EPFLRocketTeam/SupersonicTestRocket/data_logs/Hermes_subsonicFlight_Kaltbrunn[04.09.2021]-RAW/atlimax_zoom.png

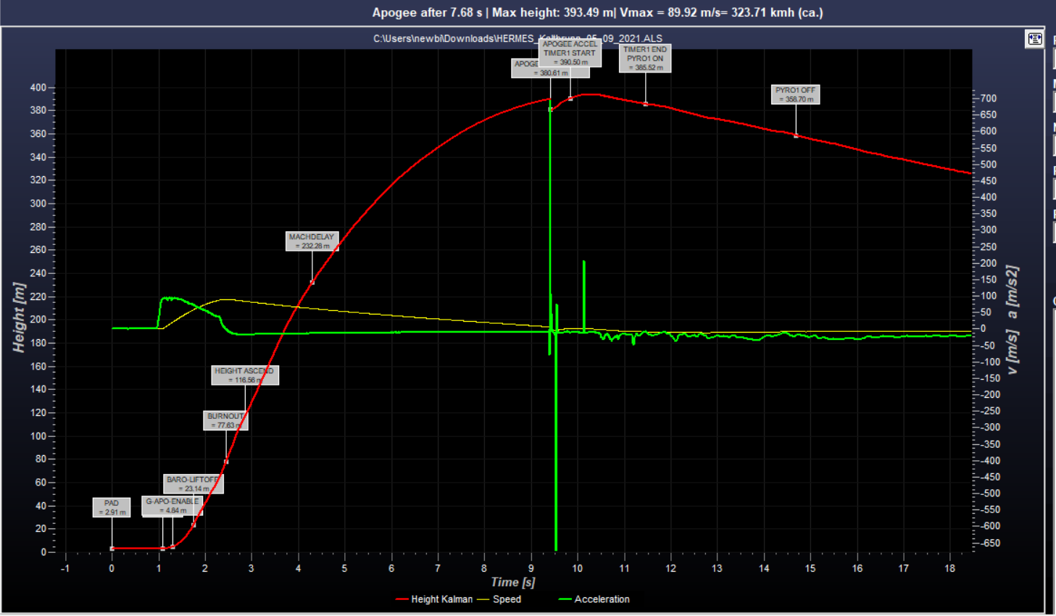
data_logs/Hermes_subsonicFlight_Kaltbrunn[04.09.2021]-RAW/atlimax_zoom.png
