EPFLRocketTeam/SupersonicTestRocket/datasheets/AISx120SX_registers.png

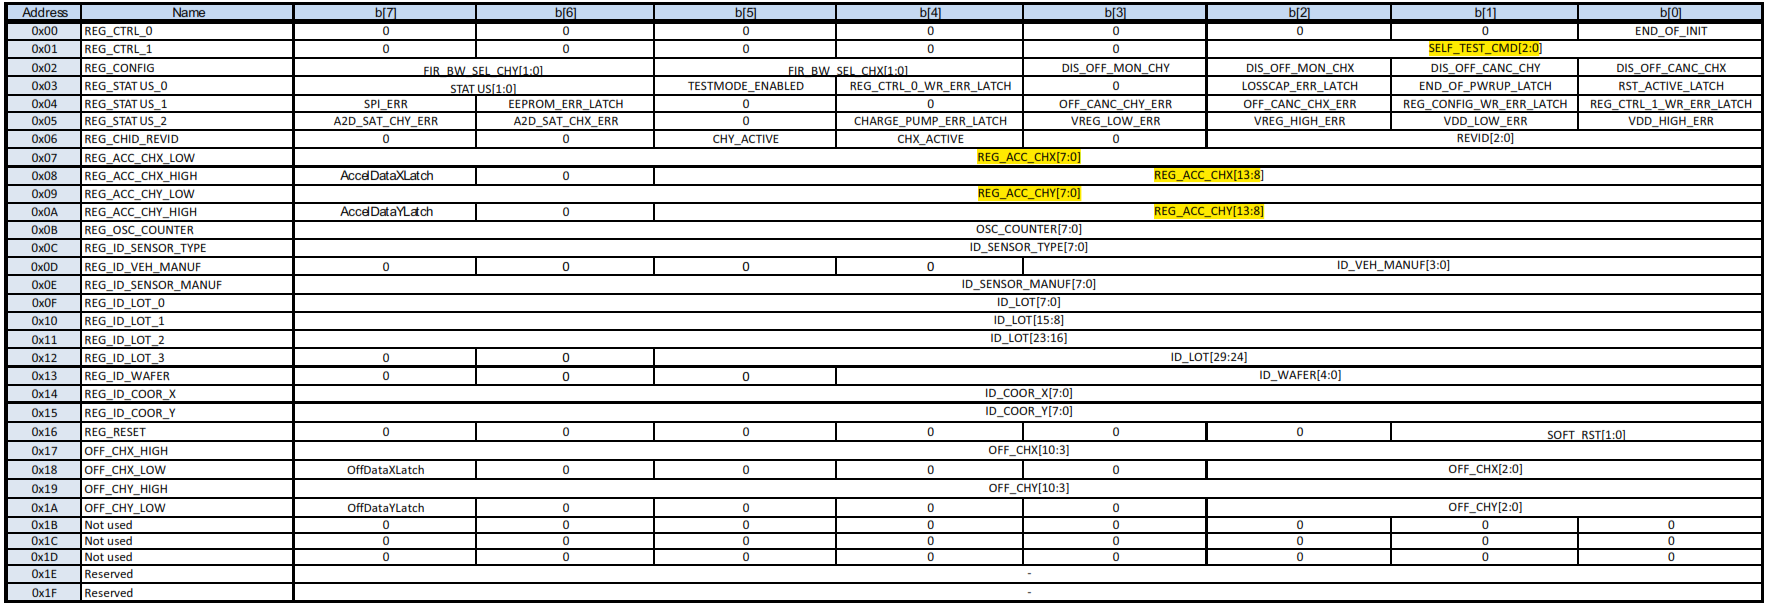
datasheets/AISx120SX_registers.png
