EPFLRocketTeam/SupersonicTestRocket/datasheets/nosecone_pinout.PNG

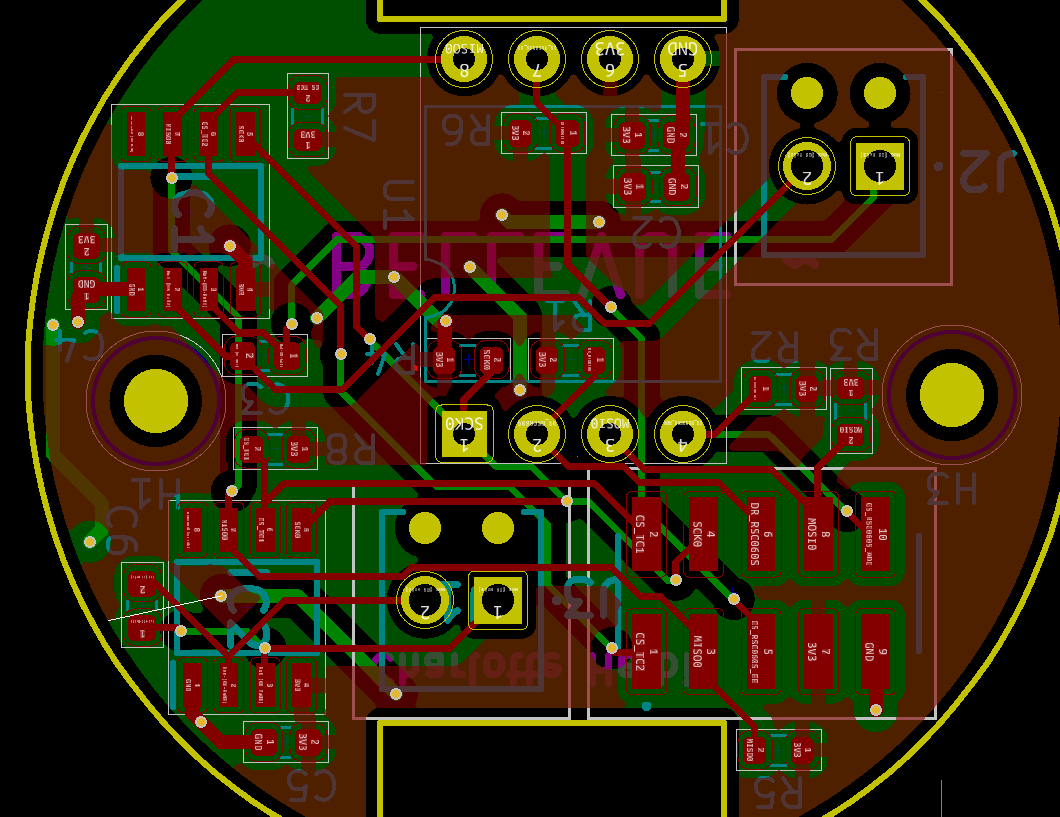
datasheets/nosecone_pinout.PNG
