EPFLRocketTeam/SupersonicTestRocket/doc_data_logger/html/class_honeywell_r_s_c___pressure___packet.png

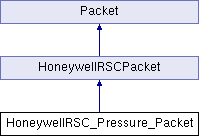
doc_data_logger/html/class_honeywell_r_s_c___pressure___packet.png
