EPFLRocketTeam/SupersonicTestRocket/PCB/PCB_v3_1/PCB_vf.png

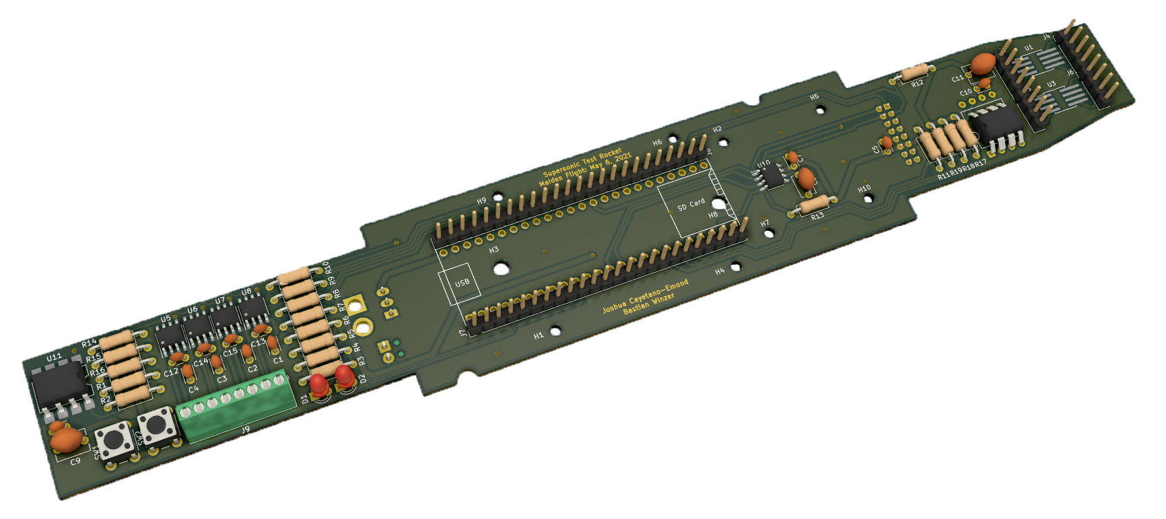
PCB/PCB_v3_1/PCB_vf.png
