EPFLRocketTeam/SupersonicTestRocket/PCB/PCB_v3_1/PCB_vf_3.png

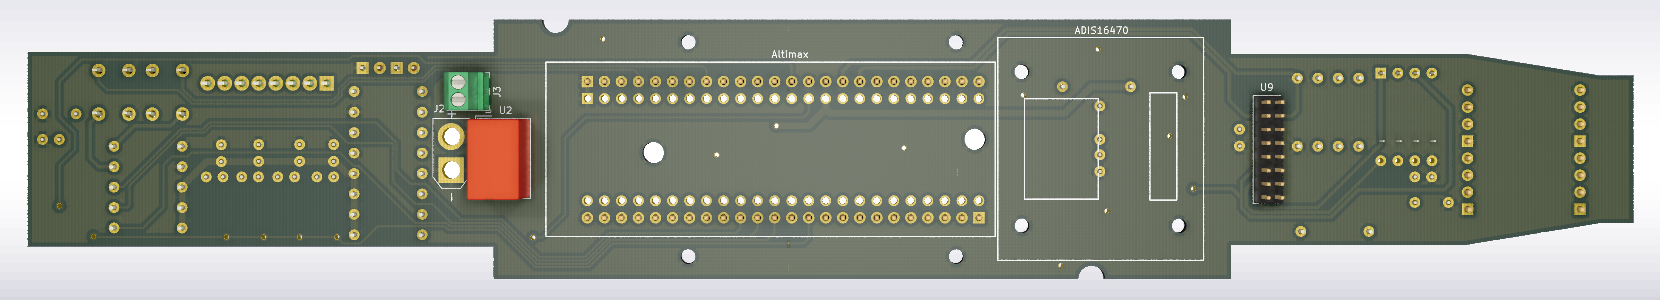
PCB/PCB_v3_1/PCB_vf_3.png
