EPFLRocketTeam/SupersonicTestRocket/PCB/PCB_v3_1/pcb_main.dxf

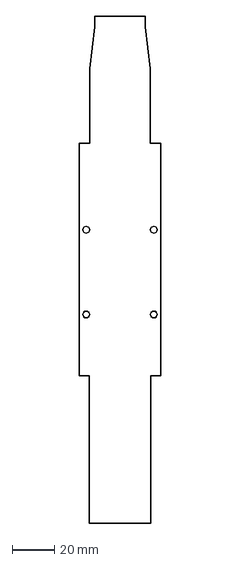
[picture p16: CAD file, 2021-05-02]
PCB/PCB_v3_1/pcb_main.dxf
38.5 x 239.5 mm
