EPFLRocketTeam/SupersonicTestRocket/PCB/PCB_v3_1/outline_WRONG.dxf

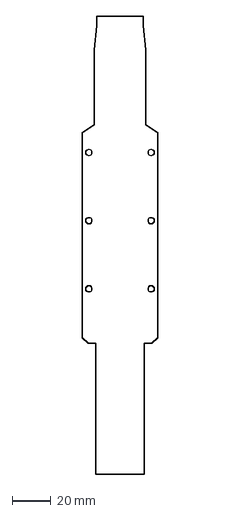
[picture p17: CAD file, 2021-05-02]
PCB/PCB_v3_1/outline_WRONG.dxf
38.5 x 235.0 mm
