EPFLRocketTeam/SupersonicTestRocket/PCB/PCB_v3_1/pcb_new.dxf

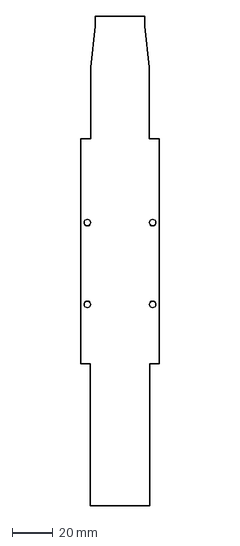
[picture p18: CAD file, 2021-05-02]
PCB/PCB_v3_1/pcb_new.dxf
38.5 x 239.5 mm
