EPFLRocketTeam/SupersonicTestRocket/PCB/PCB_v3_1/altimax_outline.dxf

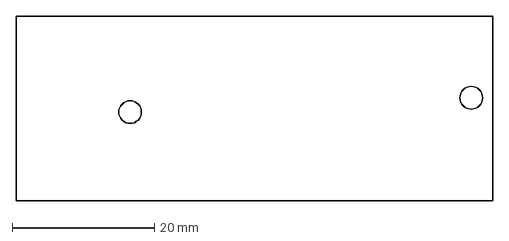
[picture p19: CAD file, 2021-05-02]
PCB/PCB_v3_1/altimax_outline.dxf
67.0 x 26.0 mm
