EPFLRocketTeam/SupersonicTestRocket/PCB/PCB_v3_1/adis16470_outline.dxf

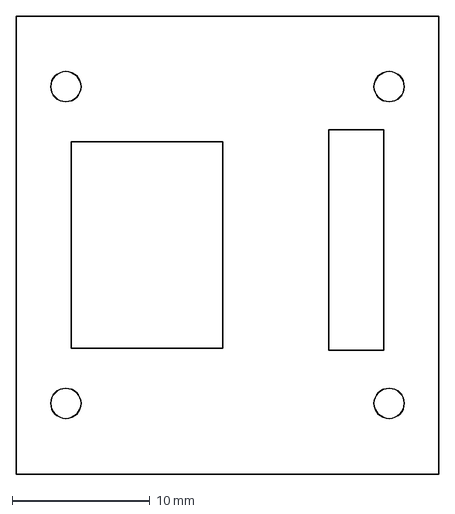
[picture p20: CAD file, 2021-05-02]
PCB/PCB_v3_1/adis16470_outline.dxf
30.7 x 33.2 mm
