EPFLRocketTeam/SupersonicTestRocket/(threads)

Thread 1 (2022-01-18):

Add basic telemetry capabilities

joshdboss, 2022-01-18:
Add a basic first version of telemetry on the rocket, both on the software and hardware side.

Tasks:
- [x] Figure out which antennas to use
- [x] Figure out which communication protocol to use
- [x] Design or find a ground station
- [x] Determine a packet structure

spacewolfXfr, 2022-03-08:
radio : XB8X -DMUS001
antennas : radio ANT433FPCUFL100, gps : ANTX100P001B1563

spacewolfXfr, 2022-03-08:
Use Wildhorn GS

spacewolfXfr, 2022-03-22:
Done here #50

Testing to be done

Thread 12 (2022-01-18):

Make the serial console printing work with the new packets

joshdboss, 2022-01-18:
The new packet format is more versatile, although not yet compatible with the serial console printing.

spacewolfXfr, 2022-02-09:
It should be OK for the sensors with wrappers. Testing is needed, as always.
 Some possible improvements:
- Add colors (define the color scheme to use)
- Add units (they are not always documented)

More general issue/question : `dataAcquisition` always does the setup and cleanup phase, but is called several time (at least once for `setup` in `main.cpp`, then in `loop`). Is this something which should be fixed ? (Split the function in `dataAcquisition_setup`, `..._core` and `..._cleanup` ?)

spacewolfXfr, 2022-03-22:
Done here #50

Closed 2022-03-22.

Thread 13 (2022-01-18):

Test the interface between the board and the Altimax

joshdboss, 2022-01-18:
An interface was created between the board and Altimax to be able to sync data logs from both sources, but it has not yet been tested.

joshdboss, 2022-02-09:
@chaxaf I forgot to tell you, but you will need to add 3 pins on the board to connect the Altimax to the Teensy for I/O. The Altimax has a Micro-Match connector (see page 23 of the manual for more info), but we can use a different connector on the Teensy if required.

Thread 14 (2022-01-18):

Add a battery management system (BMS)

joshdboss, 2022-01-18:
The board is currently rather rudimentary when it comes to its battery management. It has no clue what its voltage is and there is no protection when it comes to short circuit or reverse polarity. The following features should be added:
- [ ] Short circuit protection
- [ ] Reverse polarity protection
- [ ] A diode between the Altimax power source and the Teensy, to stop the Altimax from beeping when the Teensy is powered through USB
- [ ] A diode on the Teensy to ensure that it can be powered safely both from USB **and** a LiPo, without risking to damage the USB cable.
- [ ] A circuit that allows the Teensy to read the battery voltage
- [ ] (optional) a low battery indicator for the battery, with an LED or similar
- [ ] (optional) a capacitor that keeps enough voltage going to the Teensy to keep in powered for a safe shutdown after power loss

Closed 2022-03-08.

Thread 15 (2022-01-18):

Add an easy method to start the avionics without having to open the rocket

joshdboss, 2022-01-18:
As of now, the rocket must be opened to turn on the avionics. This is because the entire avionics powers on as soon as the battery is plugged in. A switch of some sort that can be accessible from the outside must therefore be added.
Ideas:
- Normal switch that is activated through a small hole in the rocket's body
- Magnetic switch
- Wifi switch

Closed 2022-03-01.

Thread 16 (2022-01-18):

Preliminary design of the motor retainer and load cell assembly

joshdboss, 2022-01-18:
A motor retainer and load cell assembly must be designed. Indeed, there needs to be a method that allows for the motor to be held from the top and transfer its thrust to the load cell directly. This assembly must then be somehow secured onto the fuselage of the rocket.

joshdboss, 2022-01-19:
An example design could look like this. Part A mounts the load cell and part B acts as a load path transfering device. Part B's design is made simpler if the motor is held by other means (i.e. from the boat tail), although its design can still be easily modified to have this additional function.

<a href="https://user-images.githubusercontent.com/43014078/150055061-657245d8-a40f-45cf-92ff-730888788e0e.jpg">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</a>

<a href="https://user-images.githubusercontent.com/43014078/150055124-2a841af9-d3bf-4625-a23e-a235e66d3628.jpg">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</a>

Mounting part B could actually be made smaller by wrapping around the charge cylinder if the motor does not need to be retained.

<a href="https://user-images.githubusercontent.com/43014078/150055129-20d33ceb-a4c8-4549-aa88-88f4f6f7e3dc.jpg">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</a>

Closed 2022-02-14.

Thread 17 (2022-01-18):

Add a load cell to measure rocket's thrust directly

joshdboss, 2022-01-18:
A load cell should be added in order to allow for direct measurements of the rocket's thrust.
This requires collaboration between different subsystems:
- [ ] Select a load cell suitable for the flight profile
- [ ] Create a proper wire harness and connections on the PCB for the load cell
- [ ] Create a driver/wrapper for the load cell
- [ ] EPFLRocketTeam/SupersonicTestRocket#16

joshdboss, 2022-01-24:
FX292X-100A-0200-L available on digikey (https://www.digikey.com/en/products/detail/20009605-53/223-FX292X-100A-0200-L-ND/13692561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) seems like a good choice. Analog unamplified signal with 20mV/V, so will likely require a small PCB to amplify the signal next to the load cell before transmitting the data to the Teensy.

Thread 2 (2022-01-18):

Shrink the PCB to fit within 100x38mm

joshdboss, 2022-01-18:
This size is somewhat arbitrarily chosen. However, 100mm corresponds to the maximum size above which the price for a 4-layer PCB greatly increases on JLCPCB. The 38mm size cannot be change however, as that is the (approximate) inner diameter of the rocket.

Things that can be done to do this:
- [ ] Use SMD components
- [ ] Remove some parts of the PCB and put it in the nosecone (such as the total pressure port)
- [ ] Do not screw the Altimax or IMU directly on the PCB, but rather on the avionics bay itself

joshdboss, 2022-01-18:
Additionally, it might be worthwhile to move the static pressure port onto its own board if the avionics bay is too far from the main board.

joshdboss, 2022-01-18:
The voltage regulator should probably also be changed to an SMD DC to DC converter

joshdboss, 2022-01-19:
This will actually almost certainly not be possible, due to the combined length of the Teensy (61mm) and sensor board (~50mm). Will likely have to resort to around 120mm, and pay the extra price for the slightly larger PCB. Alternatively, a 2-layer PCB might be sufficient.

joshdboss, 2022-01-31:
Dimensions of the allocated space for the PCB (note that no dimension is final yet):

- Nosecone (A): 192mm long. Outer diameter 41.9mm. Thickness of walls not yet decided, but likely ~5mm, for an inner diameter of 31.9mm at the largest. Tangent square root profile. Should ideally fit a small payload
- Shoulder (B): 40mm long. Inner diameter 31.9mm
- Avionics bay (C): 100mm long. Inner diameter 38.7mm
- Inside coupler (D): 80mm long, minus cap, for a total length of ~60mm. Inner diameter 35.7mm

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

Closed 2022-03-01.

Thread 20 (2022-01-18):

Select a material for the fuselage

joshdboss, 2022-01-18:
A material for the fuselage must be selected. Potential choices include fiberglass-reinforced phenolic, fiberglass, carbon fiber

joshdboss, 2022-01-18:
- [ ] Test the additional weigh incurred by fiberglass-reinforcing phenolic tubing. This can easily be done on a sample piece ~10-20cm long

joshdboss, 2022-02-08:
@bwinz will weigh phenolic tubing with fiberglass reinforcement over the weekend of the 12th of February

Thread 23 (2022-01-18):

Improve the thermocouple connectors

joshdboss, 2022-01-18:
The screw connectors used for the thermocouples tend to create a very unstable contact for the thermocouple connection. A better connector should be found, or a different method should be used to screw the thermocouple cable in the connector. Unfortunately, it is not recommended to solder thermocouple wire onto a board directly, so a connector must be used.

Thread 5 (2022-01-18):

Add Wildhorn's sensor board to the PCB

joshdboss, 2022-01-18:
Headers or something similar must be included on the PCB to interface with Wildhorn's sensor board. Its size might prove somewhat problematic considering the small size of the PCB

Closed 2022-03-01.

Thread 6 (2022-01-18):

Interface with Wildhorn's sensor board on the software side

joshdboss, 2022-01-18:
Code must be written to allow for a proper interface with Wildhorn's sensor board on the software side.
This includes:
- [ ] Modifying the drivers to work on our board
- [ ] Creating wrappers for each sensor
- [ ] Including the sensors in the main scripts

Thread 8 (2022-01-18):

Design a proper wire harness

joshdboss, 2022-01-18:
In its current state, the wiring between various parts of the rocket leaves much to be desired. Cables snake around the rocket and it is difficult to integrate everything before launch. As such, better wire harnessing is required.

Wire harnesses required:
- [ ] Between the main PCB and the total pressure PCB
- [ ] Between the main PCB and the pyrocutters
- [ ] Between the main PCB and the load cell

joshdboss, 2022-02-09:
Example idea for the connections of the load cell assembly.
Component 9 could have 1 or two connectors depending on how often component 6 needs to be resoldered.

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

joshdboss, 2022-02-10:
https://rapidharness.com/

Seems like an interesting software option with a freemium scheme. The free version allows 5 designs with up to 30 connections each, which should be more than enough for our case.

joshdboss, 2022-02-14:
Different components requiring wire harnessing.

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

Thread 9 (2022-01-18):

Preliminary design of the avionics bay

joshdboss, 2022-01-18:
Come up with a preliminary design of the avionics bay on paper.

joshdboss, 2022-01-19:
Example sketch of what the avionics bay could look like.

1.  Hinge
2. ADIS16470 (IMU)
3. Altimax
4. Housing (3D printed)
5. Thermocouple connectors
6. Teensy
7. PCB

<a href="https://user-images.githubusercontent.com/43014078/150049548-61bd0d46-5b93-475a-85b3-c388323c6cb8.jpg">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</a>

joshdboss, 2022-02-07:
Voici ce que j'avais en tête lorsque j'ai fait le PCB v1.5 sur KiCAD

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

Cependant, en faisant un CAD préliminaire, je réalise qu'on est probablement mieux de tourner l'Altimax car sinon ses vis vont être problématiques et nous faire perdre de l'espace.

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

Closed 2022-03-01.

Thread 24 (2022-01-19):

Redesign nosecone

joshdboss, 2022-01-19:
The nosecone must be redesigned to adopt the new, longer shape. Its interior must also be fitted so that it can contain the total pressure PCB as well as a potential payload bay.

- [ ] Create a new nosecone following the 5:1 ratio and tangent square root
- [ ] Create a replaceable tip for the metal total pressure port, in order to reduce work if part of the nosecone must be replaced. This could be done by using epoxy and dissolving it (carefully) in acetone when the component needs to be replaced.
- [ ] Likewise, create replaceable inserts for each of the thermocouples
- [ ] Create a mechanical system to allow for the PCB to be mounted
- [ ] Create a system to allow the air tubing to be tucked away when inserting the PCB
- [ ] Create room for a payload bay.

Below is schematic diagram of an example nosecone layout. The PCB and payload bay could potentially be inverted if the tubing/cabling is too long when inserting the PCB into place
<a href="url">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</a>

Thread 25 (2022-01-19):

Size and design a shear pin system

joshdboss, 2022-01-19:
As a shear pin would've likely saved the first Hermes, adding it to the second iteration is critical. This shear pin should be sized so that it doesn't allow the rocket to separate prematurely, while allowing the rocket to separate with either of the ejection charges.

- [ ] Calculate the maximum expected tension force caused by drag on the rocket (adding a healthy safety factor)
- [ ] Calculate a typical ejection charge's compressive force
- [ ] Size the shear pin accordingly
- [ ] Integrate the pins into the design

Thread 29 (2022-01-22):

Redesign the static pressure port

joshdboss, 2022-01-22:
The static pressure port should be redesigned, or at the very least its design should be investigated and we should determine if there is a better alternative to the previous design.

Thread 40 (2022-03-01):

Ejection tests

joshdboss, 2022-03-01:
The ejection capabilities of the rocket must be validated using both the main charge and the secondary one. Potential damage to the load cell must be examined.
