EPFLRocketTeam/SupersonicTestRocket/PCB/PCB_v3_1/Gerber/PCB_v1-B_Adhes.pdf

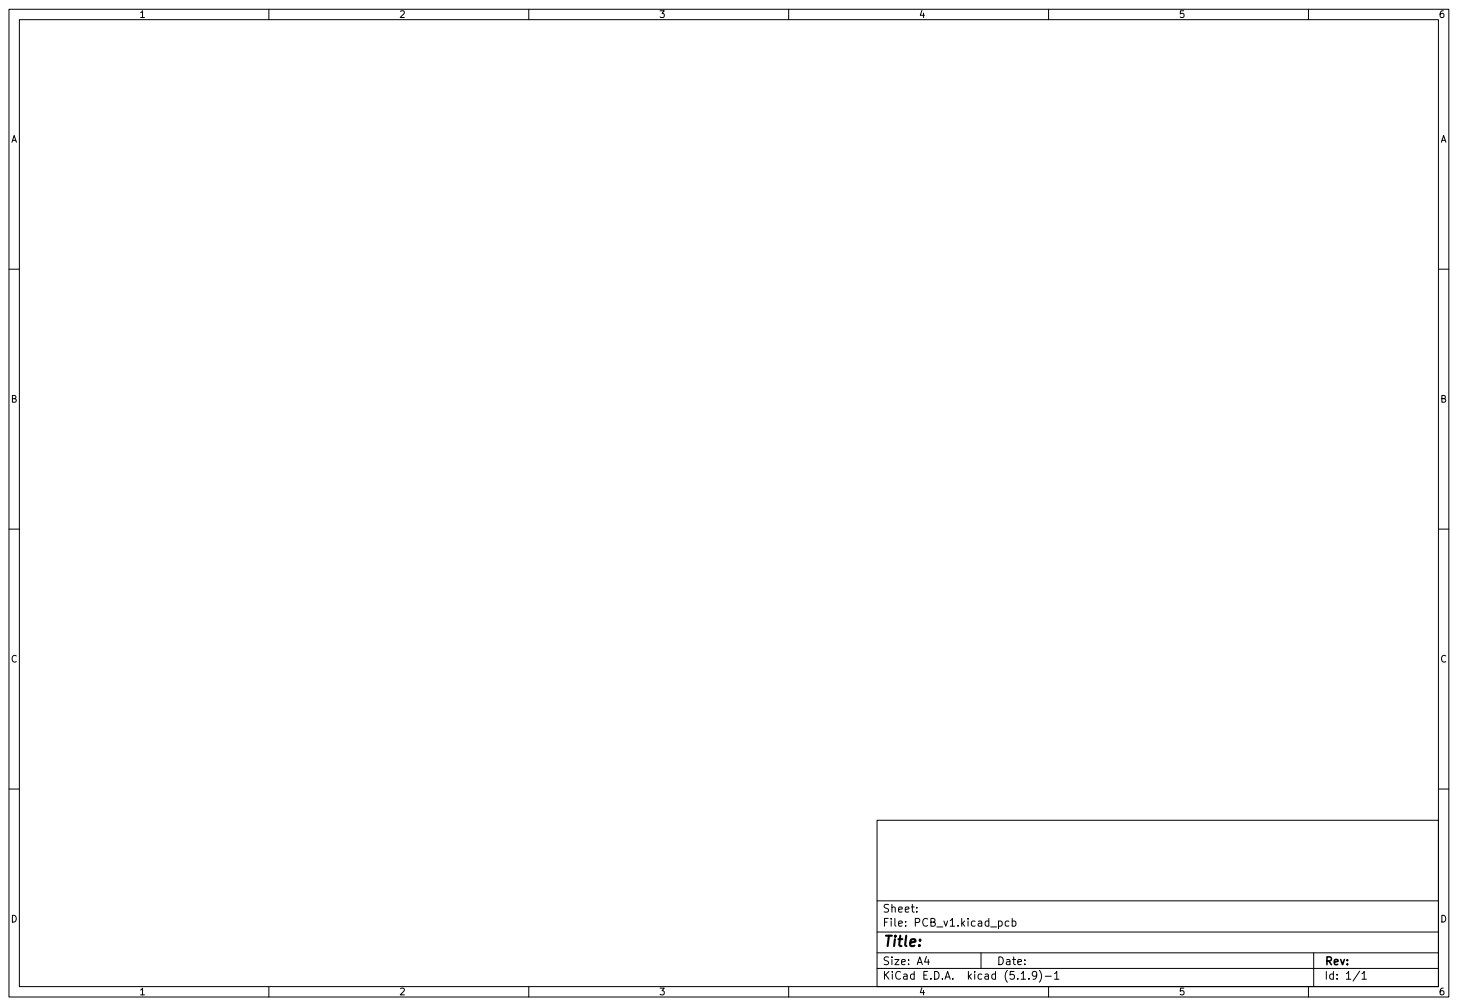
[picture p55: page 1]
