EPFLRocketTeam/SupersonicTestRocket/PCB/PCB_v3_1/Gerber/PCB_v1-B_CrtYd.pdf

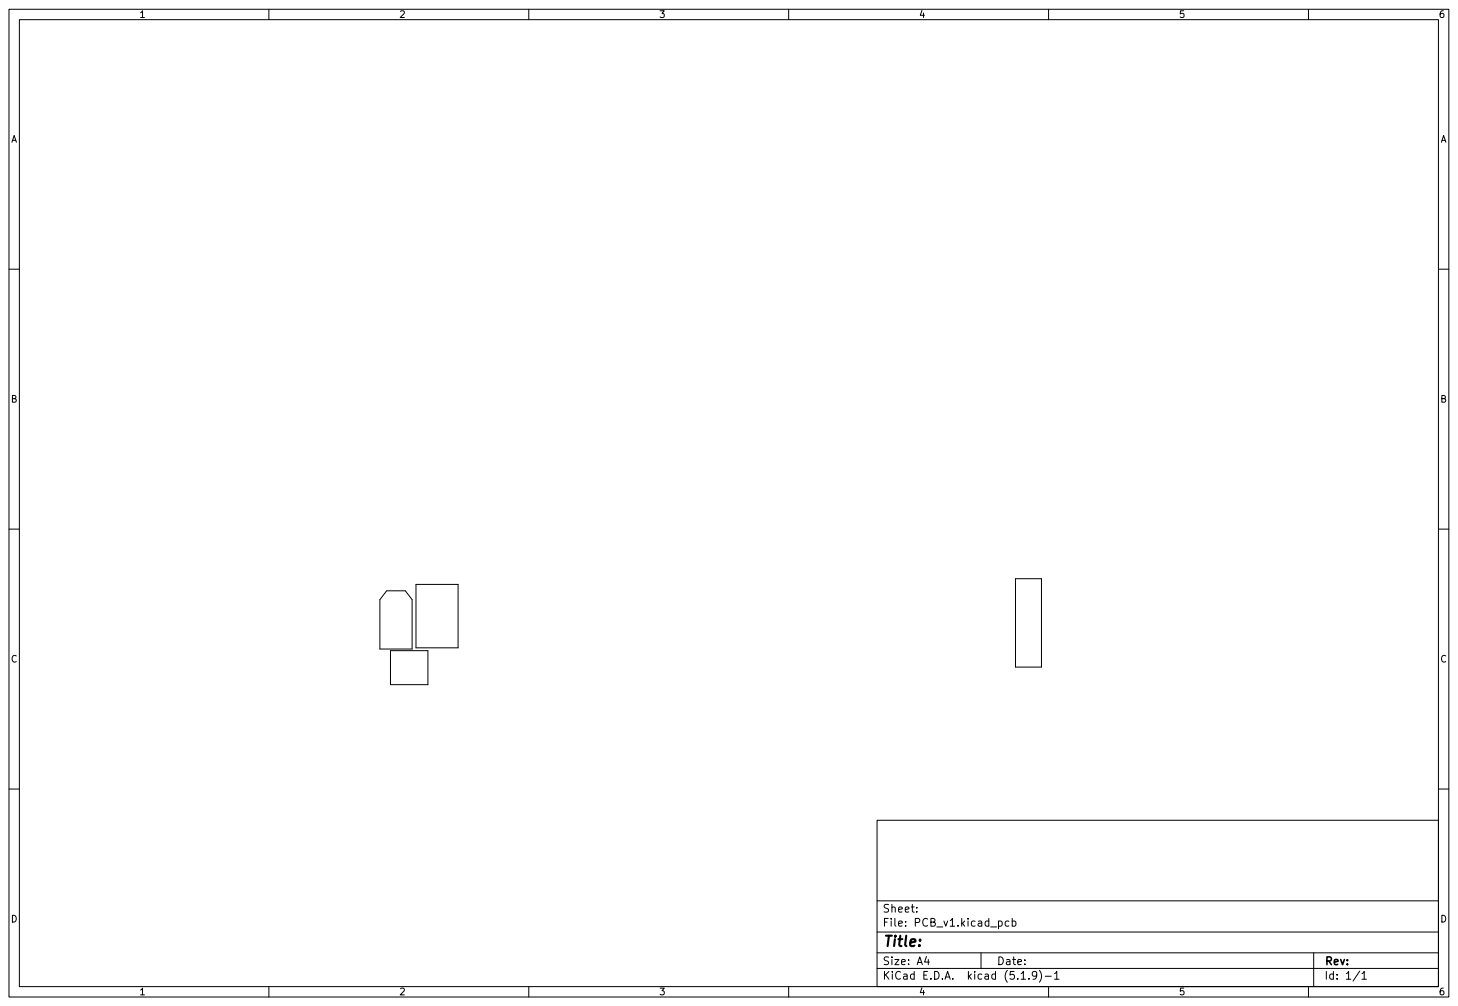
[picture p56: page 1]
