EPFLRocketTeam/SupersonicTestRocket/PCB/PCB_v3_1/Gerber/PCB_v1-B_Cu.pdf

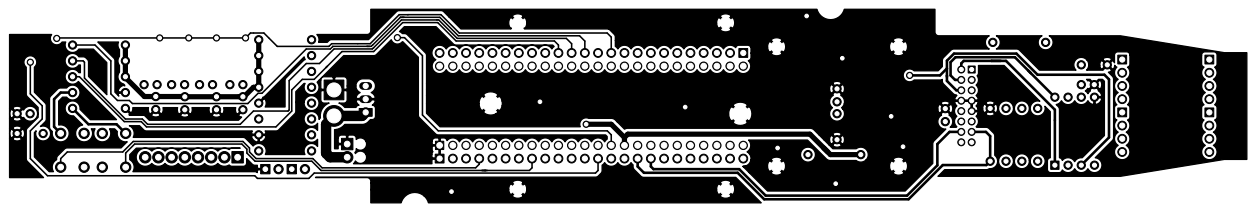
[picture p57: page 1]
