EPFLRocketTeam/SupersonicTestRocket/PCB/PCB_v3_1/Gerber/PCB_v1-B_Fab.pdf

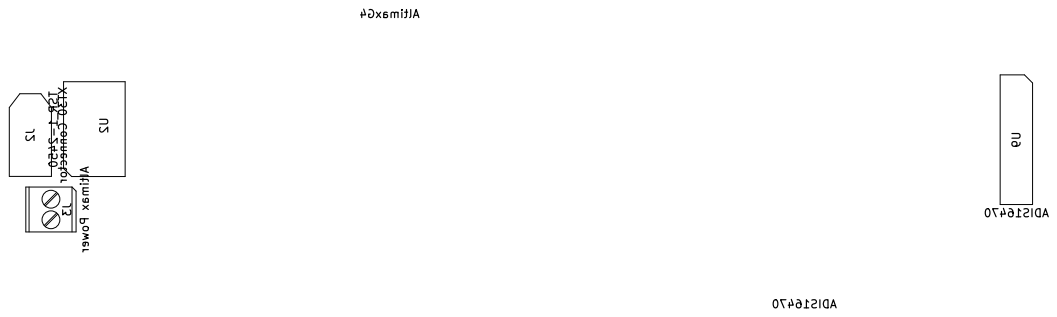
[picture p58: page 1]
