EPFLRocketTeam/SupersonicTestRocket/PCB/PCB_v3_1/Gerber/PCB_v1-B_Mask.pdf

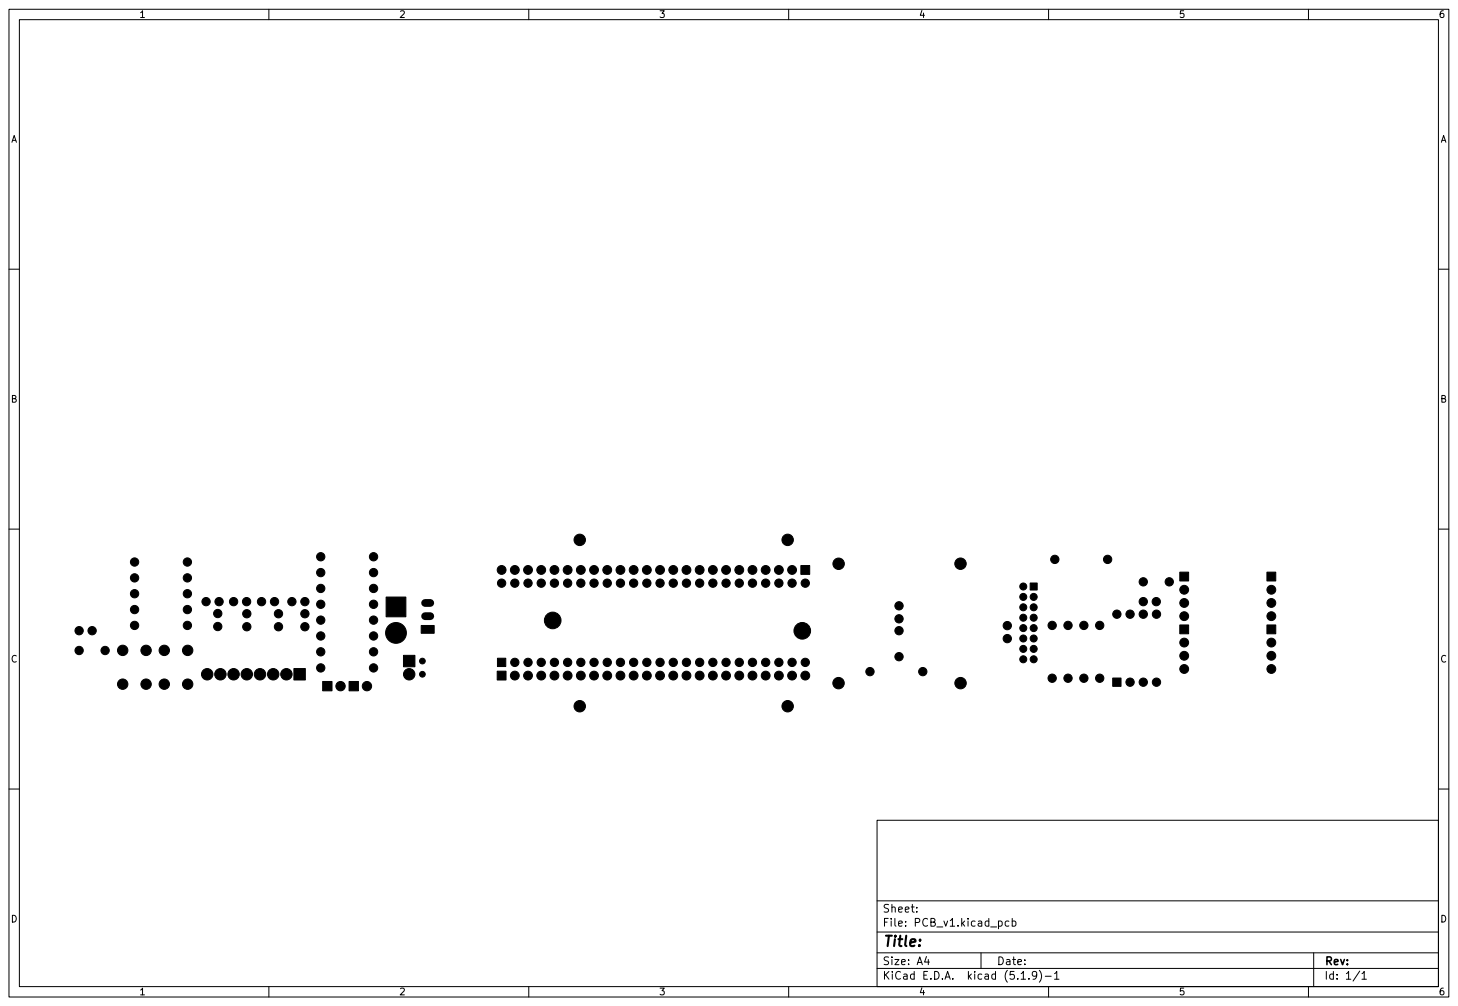
[picture p59: page 1]
