EPFLRocketTeam/SupersonicTestRocket/PCB/PCB_v3_1/Gerber/PCB_v1-Cmts_User.pdf

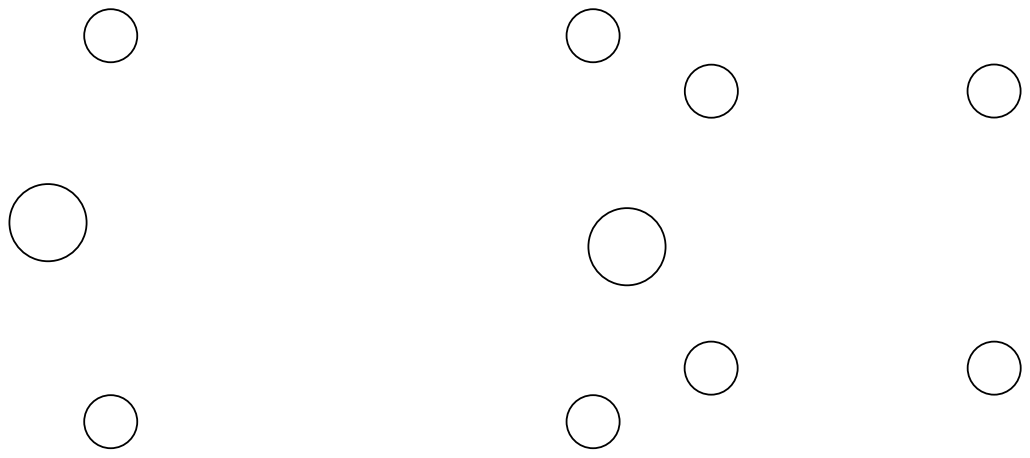
[picture p61: page 1]
