EPFLRocketTeam/SupersonicTestRocket/PCB/PCB_v3_1/Gerber/PCB_v1-Dwgs_User.pdf

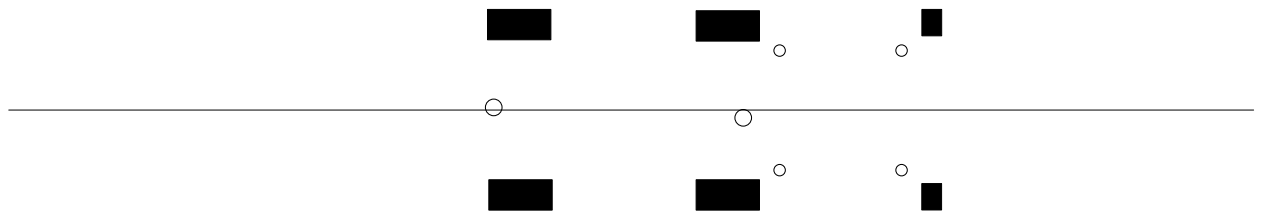
[picture p62: page 1]
