EPFLRocketTeam/SupersonicTestRocket/PCB/PCB_v3_1/Gerber/PCB_v1-Edge_Cuts.pdf

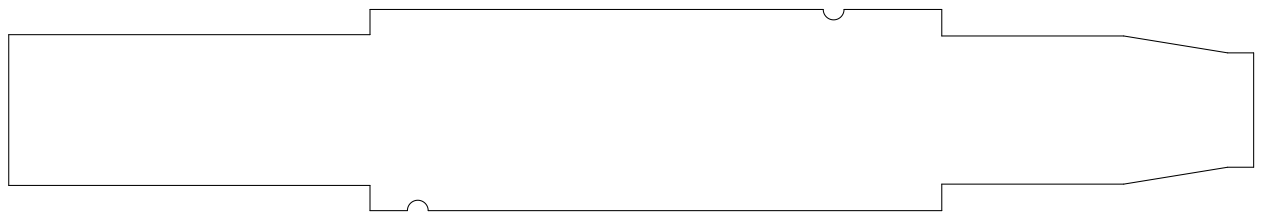
[picture p63: page 1]
