EPFLRocketTeam/SupersonicTestRocket/PCB/PCB_v3_1/Gerber/PCB_v1-F_CrtYd.pdf

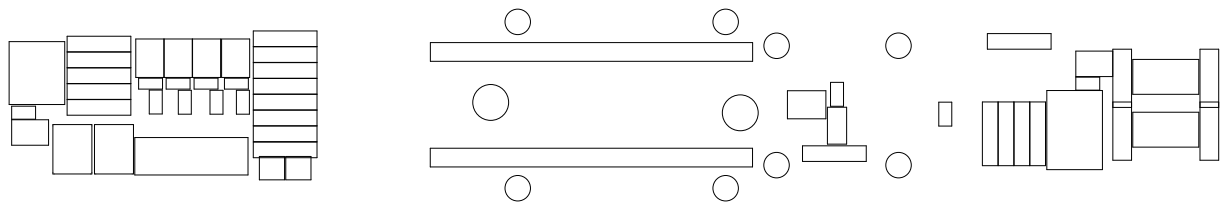
[picture p64: page 1]
