EPFLRocketTeam/SupersonicTestRocket/PCB/PCB_v3_1/Gerber/PCB_v1-F_Cu.pdf

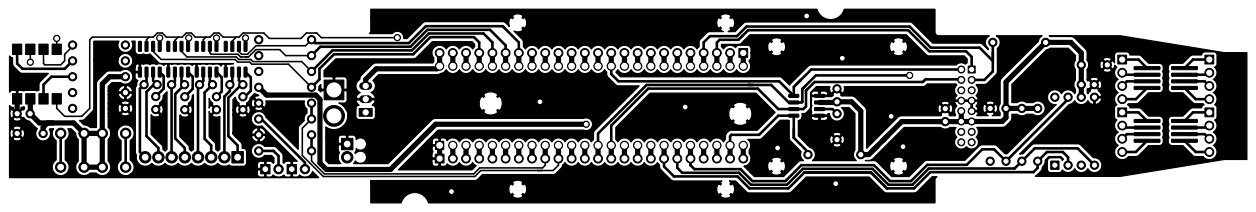
[picture p65: page 1]
