EPFLRocketTeam/SupersonicTestRocket/PCB/PCB_v3_1/Gerber/PCB_v1-F_Fab.pdf

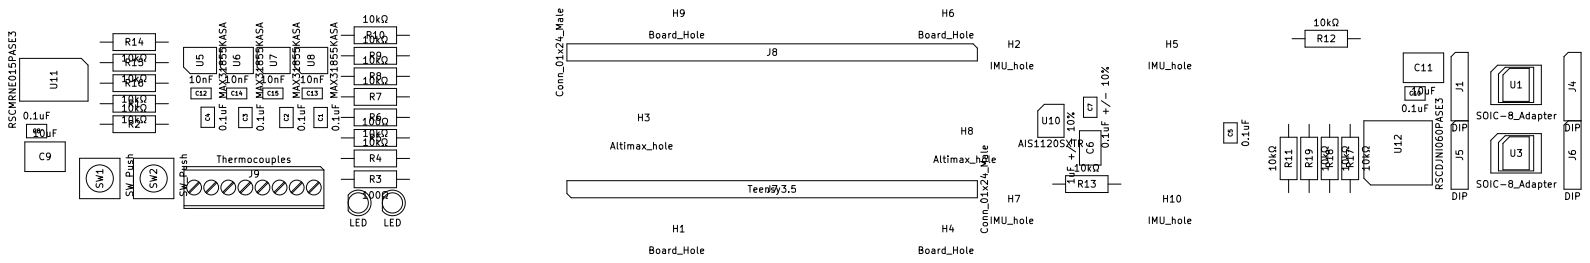
[picture p66: page 1]
