EPFLRocketTeam/SupersonicTestRocket/PCB/PCB_v3_1/Gerber/PCB_v1-F_Mask.pdf

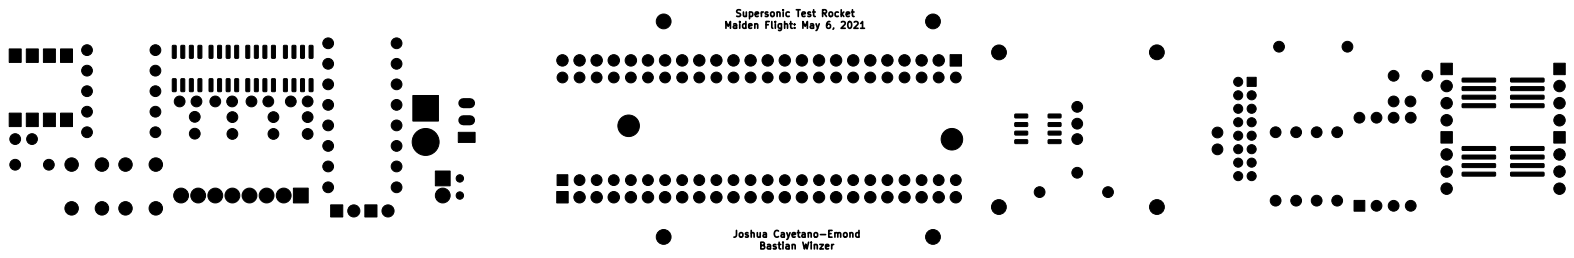
[picture p67: page 1]

Supersonic Test Rocket Maiden Flight: May 6, 2021

Joshua Cayetano-Emond Bastian Winzer
