EPFLRocketTeam/SupersonicTestRocket/PCB/PCB_v3_1/Gerber/PCB_v1-F_Paste.pdf

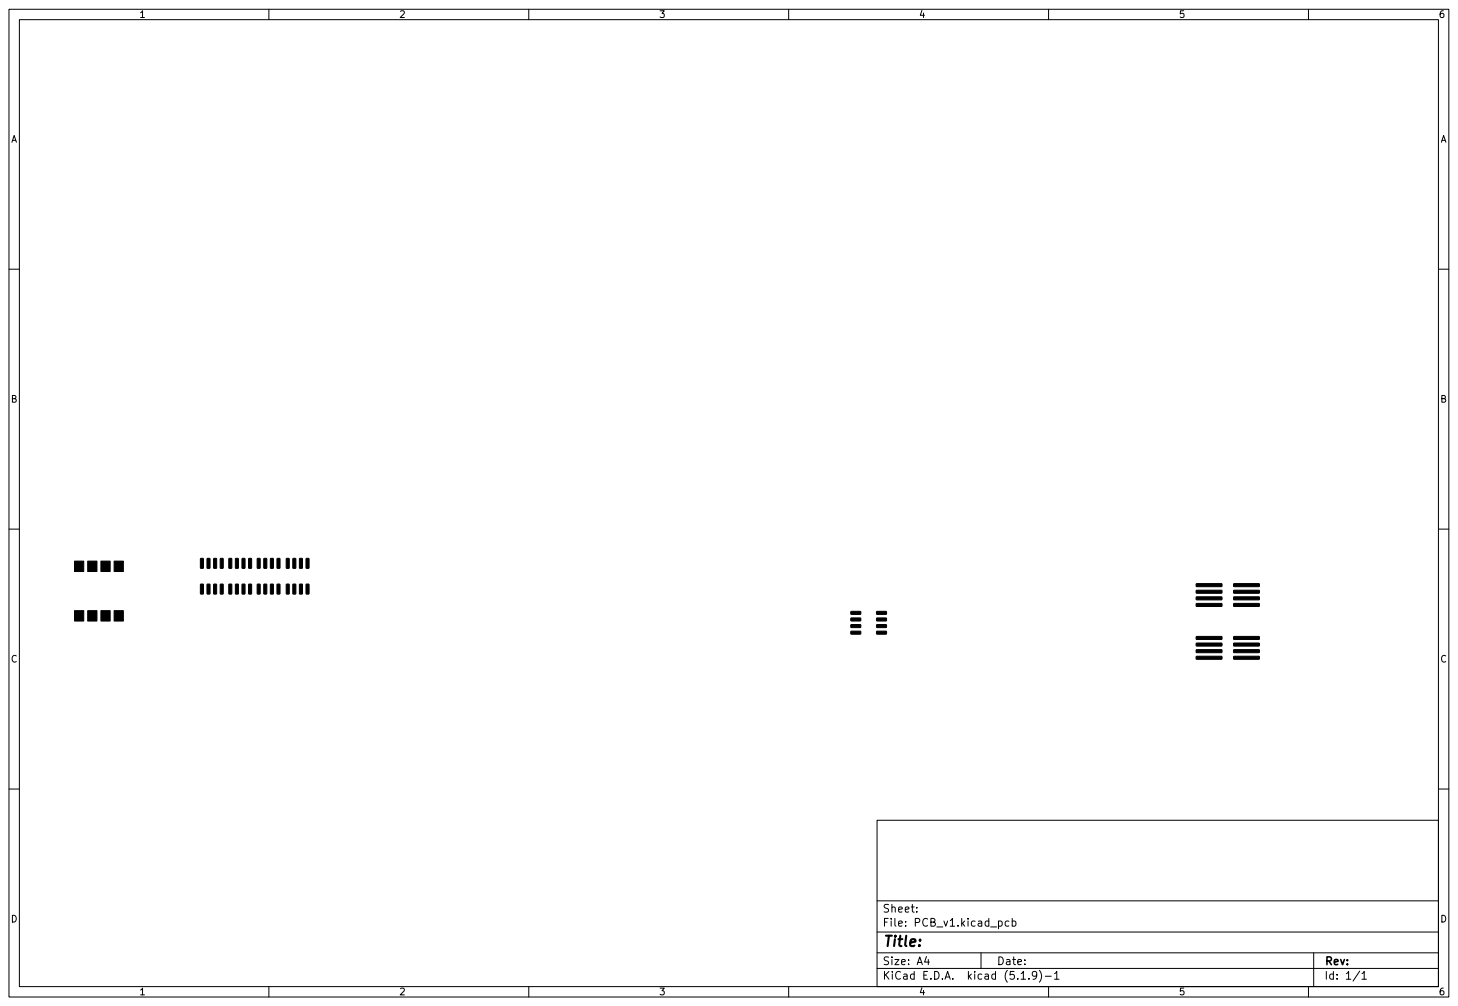
[picture p68: page 1]
