EPFLRocketTeam/SupersonicTestRocket/PCB/PCB_v3_1/PCB_v1.kicad_pcb

## KiCad design PCB/PCB_v3_1/PCB_v1.kicad_pcb (2022-03-25)

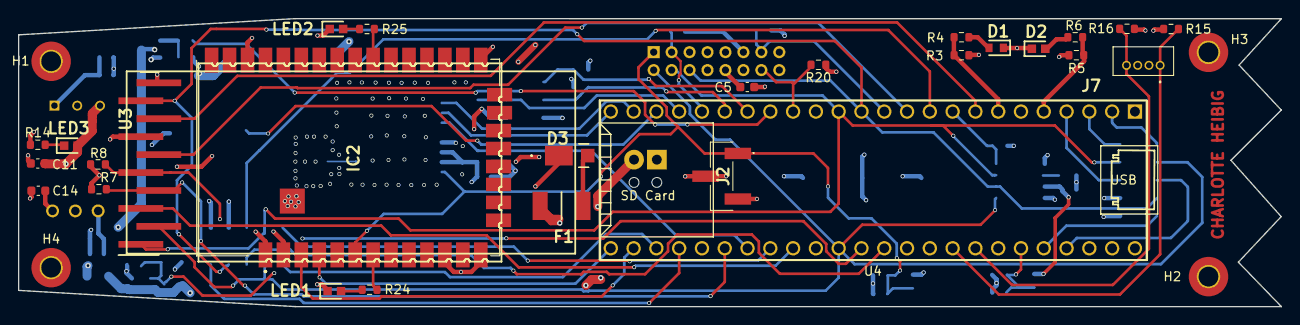
[picture p70: board PCB/PCB_v3_1/PCB_v1.kicad_pcb from above]

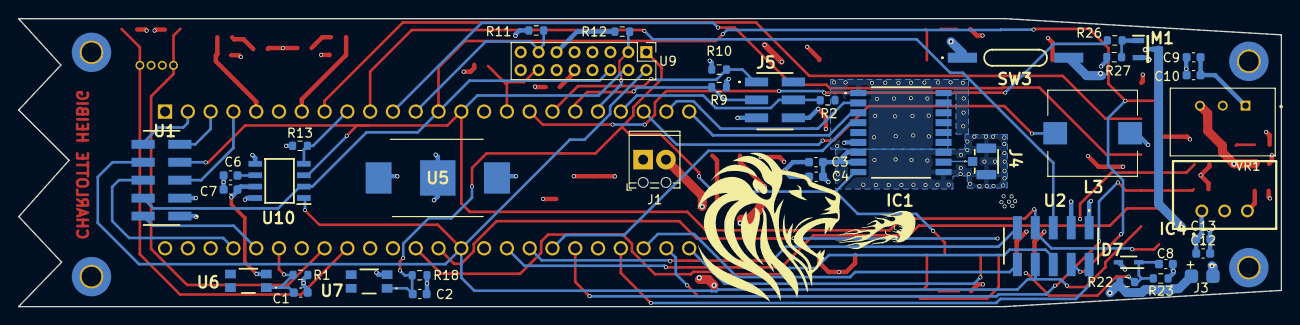
[picture p71: board PCB/PCB_v3_1/PCB_v1.kicad_pcb from below]

Board: 4 copper layers, 140.8 x 32.1 mm, 72 parts (41 on the bottom side), 57 nets.

Parts:
C1, C2, C3, C5, C10, C11, C13, C14: 100nF; C_0603_1608Metric
C4, C9, C12: 10uF; C_0603_1608Metric
C6: 1uF +/- 10% 10V; C_0603_1608Metric
C7: 100nF +/- 10% 10V; C_0603_1608Metric
C8: 1uF; C_0603_1608Metric
D1: White LED; LEDC1608X45N
D2: Red LED; LEDC1608X80N
D3: D_Schottky; V8PAN50M3I
D7: BZX584C3V3-G3-08; SOD2513X110N
F1: MINIASMDC150F_12-2; MINISMDC050F2
H1, H2, H3, H4: Board_Hole; MountingHole_2.2mm_M2_Pad_TopBottom
IC1: MAX-7C-0; MAX7C0
IC2: XB8X-DMUS-001; XBP9XDMRS001
IC4: TSR_0.5-2433; TSR-0.5-2433
J1: Altimax Power; TerminalBlock_Phoenix_MPT-0,5-2-2.54_1x02_P2.54mm_Horizontal
J2: 0878980304
J3: LiPo Connection; pad2
J4: CONUFL001-SMD-T; CONUFL001-SMD
J5: 57202G5203LF
J7: 1734598-4; 17345984
L3: SMI-1027-T-5V-R; SMI1027T5VR
LED1, LED2, LED3: 150060GS75000; LEDC1608X80N
M1: MNMOS; SOT95P237X112-3N
R1, R4, R6, R11, R12, R13, R20: 10kΩ; R_0603_1608Metric
R2, R9, R10, R15, R16, R18: 10k; R_0603_1608Metric
R3: 100Ω; R_0603_1608Metric
R5: 24Ω; R_0603_1608Metric
R7, R8, R27: 10kOhm; R_0603_1608Metric
R14: 10K; R_0603_1608Metric
R22, R23: ?; R_0603_1608Metric
R24, R25: 24; R_0603_1608Metric
R26: R; R_0603_1608Metric
SW3: MISM7R610
U1, U2: 57202G5205LF
U3: 1-2842102-0; HUSRSP10W50P200_2000X200X550P
U4: Teensy3.5; Teensy35_36_exterior_pins_only
U5: 3030
U6, U7: switch; RKC2SJF170SMTRLFS
U9: ADIS16470; PinHeader_2x08_P2.00mm_Vertical
U10: AIS1120SXTR; SOIC127P600X175-8N
VR1: TSR1-2450; CONV_TSR1-2450

Connections:
+3V3: C2.1, C3.1, C4.1, C5.1, C7.1, C14.1, IC1.7 (VCC_IO), IC1.8 (VCC), IC2.2 (VCC), IC4.3 (+VOUT), J5.6, R7.1, R8.1, R12.1, R13.1, R15.2, R16.2, R18.1, U1.3, U2.3, U3.7, U6.3, U9.10 (VDD), U9.11 (VDD), U9.12 (VDD), U10.7 (VDD)
+5V: C11.1, C12.1, C13.1, IC4.1 (+VIN), J7.3, LED3.2, U4.53 (Vin), VR1.3 (+VOUT)
/MISO0: U1.7, U2.7, U3.1, U4.14 (12_MISO0), U9.4 (DOUT), U10.3 (SDO)
/MOSI0: U1.4, U2.4, U3.9, U4.13 (11_MOSI0), U9.6 (DIN), U10.2 (SDI)
/RTC_supply: IC1.6 (V_BCKP), J2.2, U5.1, U5.3
/SCK0: U1.8, U2.8, U3.2, U4.40 (13_SCK0_LED), U9.2 (SCLK), U10.1 (SCL)
/aux1: J5.3, R9.2, U4.19 (27_RX1_SCK0)
/aux2: J5.1, R10.2, U4.18 (26_TX1_SCL2)
/aux3: J5.4, R2.1, U4.21 (29_PWM_CAN0TX_Touch)
/bat_voltage: C8.2, D7.1, R22.2, R23.1, U4.41 (14_A0_PWM_SCK0)
/button1: C1.1, R1.1, U4.48 (21_A7_PWM_CS0_MOSI1), U6.1
/buzzer_input: L3.1, U4.22 (30_PWM_CAN0RX_Touch)
/cs_acc: R13.2, U4.9 (7_RX3_MOSI0_SCL0), U10.4 (CS)
/cs_adis: R12.2, U4.20 (28_MOSI0), U9.3 (CS)
/cs_pressure_adc_1: U1.2, U4.49 (22_A8_PWM_Touch)
/cs_pressure_adc_2: U2.2, U4.33 (36_A17_PWM)
/cs_pressure_ee_1: U1.5, U4.4 (2_PWM)
/cs_pressure_ee_2: U2.5, U4.10 (8_TX3_MISO0_SDA0)
/cs_tc1: U1.9, U4.3 (1_TX1_MISO1_Touch)
/cs_tc2: U1.10, U4.2 (0_RX1_MOSI1_Touch)
/cs_tc3: U2.9, U4.37 (A21_DAC0)
/cs_tc4: U2.10, U4.32 (35_A16_PWM)
/dr_adis: R11.2, U4.12 (10_PWM_TX2_CS0), U9.13 (DR)
/dr_pressure_1: U1.6, U4.50 (23_A9_PWM_Touch)
/dr_pressure_2: U2.6, U4.42 (15_A1_CS0_Touch)
/enable_gnd: R26.1, U4.17 (25)
/gp0_spi: U3.3, U4.38 (A22_DAC1)
/gp3_spi: U3.8, U4.8 (6_PWM)
/gp4_spi: U3.6, U4.11 (9_PWM_RX2_CS0)
/led1: R3.2, R4.1, U4.7 (5_PWM_TX1_MISO1)
/led2: R5.1, R6.2, U4.5 (3_PWM_CAN0TX_SCL2)
/load_minus: J7.1, R15.1, U4.45 (18_A4_SDA0_Touch)
/load_plus: J7.4, R16.1, U4.46 (19_A5_SCL0_Touch)
/nReset: C2.2, IC1.9 (RESET_N), IC2.6 (~RESET), J2.1, R18.2, U7.1, U9.1 (RST)
/rx_ublox: IC1.3 (RXD), U4.24 (32_A13_TX4_SCK1)
/rx_xbee: IC2.4 (DIN/DIO14/~CONFIG), U4.30 (33_A14_TX5_CAN1TX_SCL0)
/scl_i2c: R8.2, U3.5, U4.34 (37_A18_PWM_SCL1)
/sda_i2c: R7.2, U3.4, U4.35 (38_A19_PWM_SDA1)
/sync_adis: R20.2, U4.16 (24), U9.14 (SYNC)
/timepulse_ublox: IC1.4 (TIMEPULSE), U4.36 (39_A20)
/tx_ublox: IC1.2 (TXD), U4.23 (31_A12_RX4_CS1)
/tx_xbee: IC2.3 (DIO13/DOUT), U4.31 (34_A15_RX5_CAN1RX_SDA0)
GND: C1.2, C3.2, C4.2, C5.2, C6.2, C7.2, C8.1, C9.2, C10.2, C11.2, C12.2, C13.2, C14.2, D1.1 (K), D2.1 (K), D7.2, H1.1, H2.1, H3.1, H4.1, IC1.1 (GND_1), IC1.10 (GND_2), IC1.12 (GND_3), IC2.1 (GND_1), IC2.11 (GND_2), IC2.13 (GND_3), IC2.22 (GND_4), IC2.35 (GND_5), IC2.38 (GND_6), IC4.2 (GND), J2.3, J4.2 (GND_1), J4.3 (GND_2), J5.5, J7.2, L3.2, LED1.1, LED2.1, M1.2 (S), R1.2, R2.2, R4.2, R6.1, R9.1, R10.1, R11.1, R14.2, R20.1, R23.2, R27.2, SW3.1 (A), U1.1, U2.1, U3.10, U4.1 (GND), U4.39 (GND), U5.2, U7.3, U9.7 (GND), U9.8 (GND), U9.9 (GND), U10.5 (GND), U10.8 (MP), VR1.2 (GND)
unnamed: C6.1, U10.6 (VREG)
unnamed: C9.1, C10.1, D3.1 (K), VR1.1 (+VIN)
unnamed: D1.2 (A), R3.1
unnamed: D2.2 (A), R5.2
unnamed: D3.2 (A), F1.2
unnamed: F1.1, J1.2, J3.2, R22.1
unnamed: IC1.11 (RF_IN), J4.1 (SIG)
unnamed: IC2.7 (DIO10/RSSI/PWM0), R24.1
unnamed: IC2.28 (DIO5/ASSOC), R25.2
unnamed: J1.1, J3.1, M1.1 (D), SW3.2 (B)
unnamed: LED1.2, R24.2
unnamed: LED2.2, R25.1
unnamed: LED3.1, R14.1
unnamed: M1.3 (G), R26.2, R27.1
