EPFLRocketTeam/SupersonicTestRocket/PCB/PCB_v2_5/PCB_v1.kicad_pcb

## KiCad design PCB/PCB_v2_5/PCB_v1.kicad_pcb (2021-05-02, an earlier design)

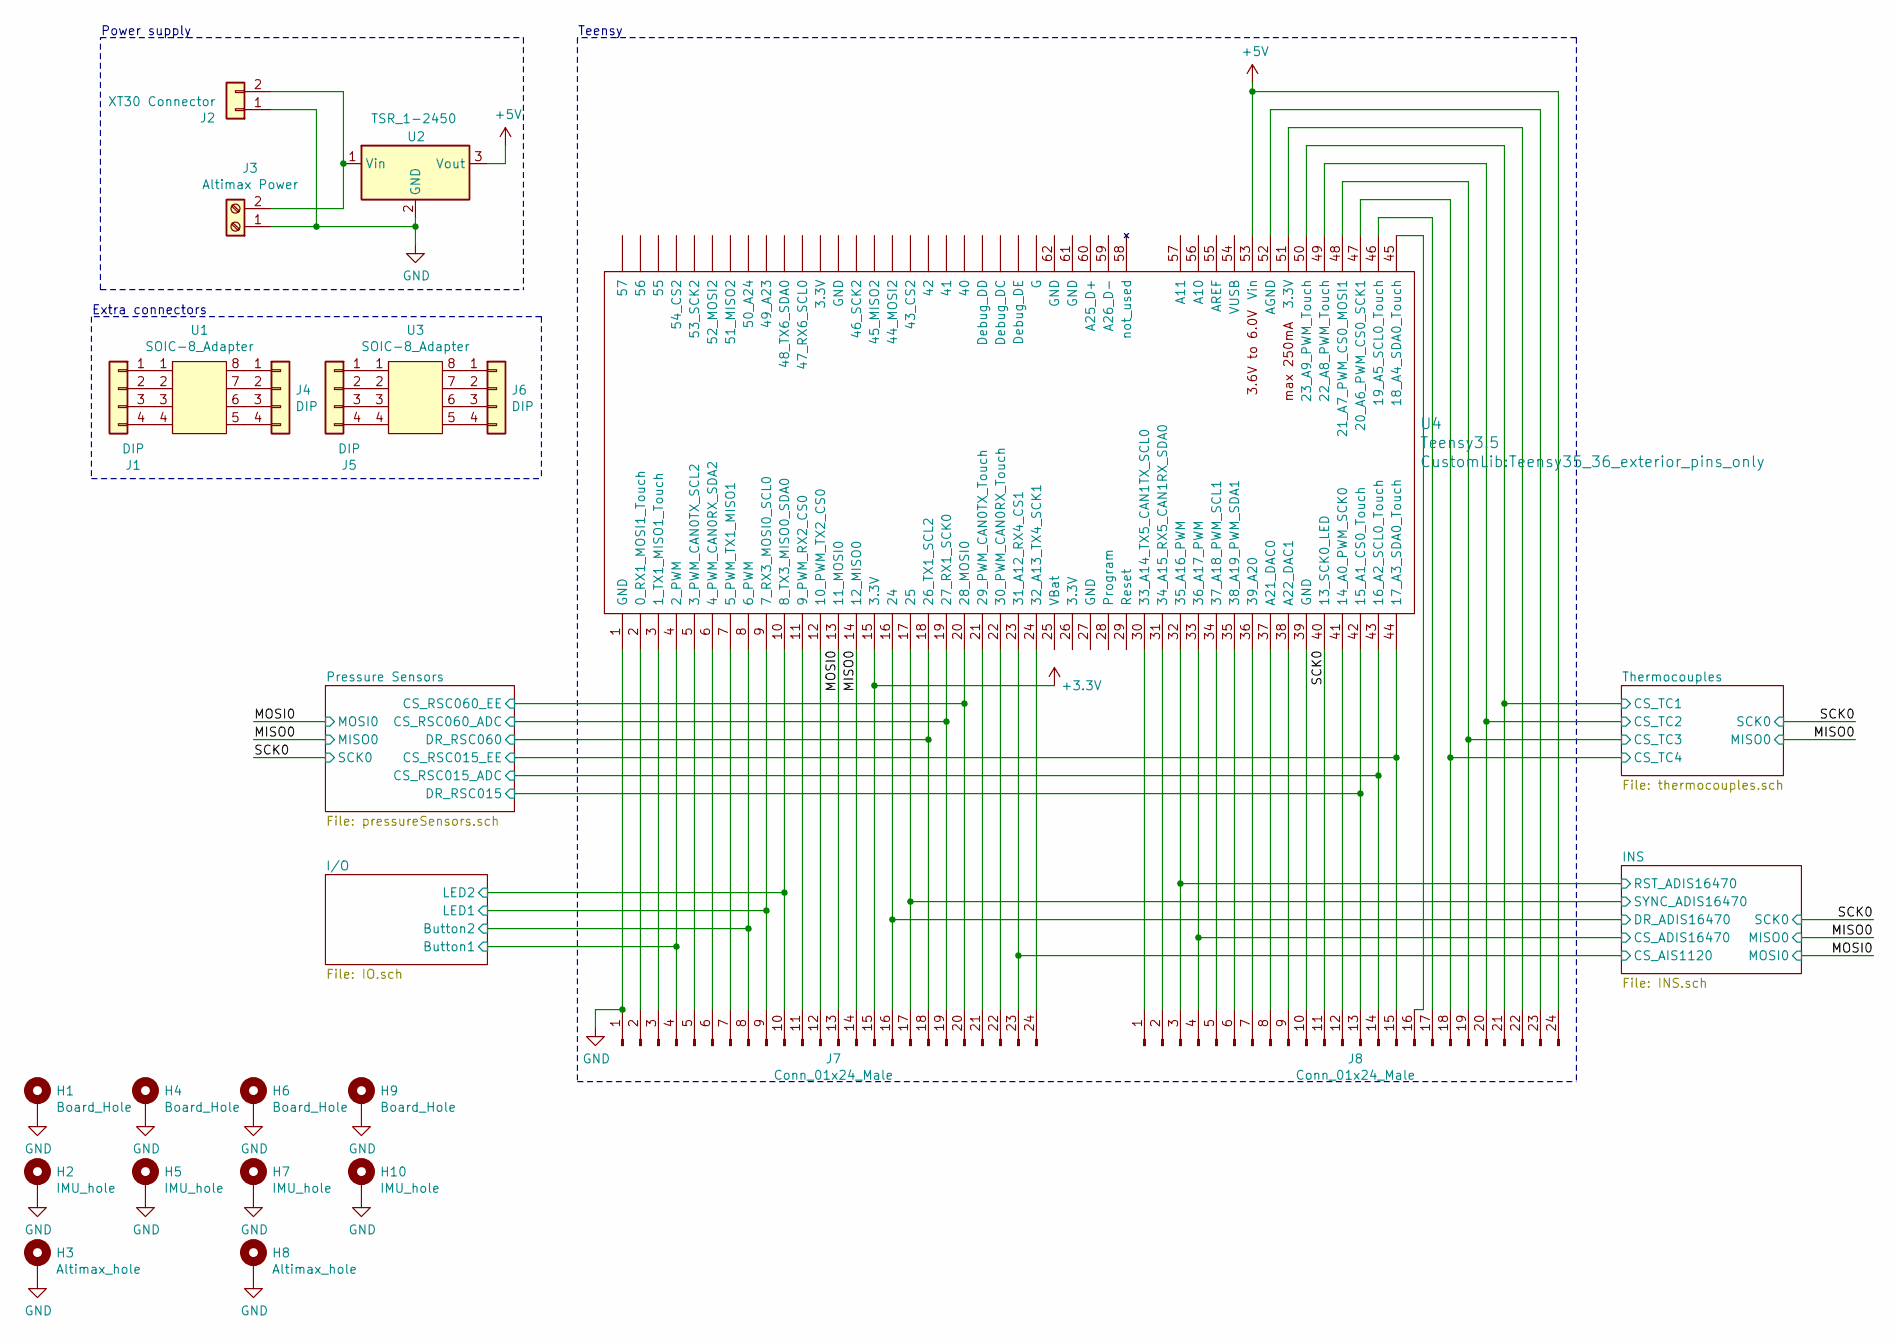
[picture p72: schematic PCB_v1.sch]

Parts:
H1, H4, H6, H9: Board_Hole; MountingHole_2.2mm_M2
H2, H5, H7, H10: IMU_hole; MountingHole_2.2mm_M2
H3, H8: Altimax_hole; MountingHole_3.2mm_M3
J1, J4, J5, J6: DIP; PinHeader_1x04_P2.54mm_Vertical
J2: XT30 Connector; AMASS_XT30U-F_1x02_P5.0mm_Vertical
J3: Altimax Power; TerminalBlock_Phoenix_MPT-0,5-2-2.54_1x02_P2.54mm_Horizontal
J7, J8: Conn_01x24_Male; PinHeader_1x24_P2.54mm_Vertical
U1, U3: SOIC-8_Adapter; SOIC-8_3_to_8mm_P1.27mm
U2: TSR_1-2450; Converter_DCDC_TRACO_TSR-1_THT
U4: Teensy3.5; Teensy35_36_exterior_pins_only

Connections:
+3V3: J7.15, U4.15 (3.3V); also elsewhere on the board
+5V: J8.24, U2.3 (Vout), U4.53 (Vin)
/I/O/Button1: J7.4, U4.4 (2_PWM); also elsewhere on the board
/I/O/Button2: J7.8, U4.8 (6_PWM); also elsewhere on the board
/I/O/LED1: J7.9, U4.9 (7_RX3_MOSI0_SCL0); also elsewhere on the board
/I/O/LED2: J7.10, U4.10 (8_TX3_MISO0_SDA0); also elsewhere on the board
/INS/CS_ADIS16470: J8.4, U4.33 (36_A17_PWM); also elsewhere on the board
/INS/CS_AIS1120: J7.23, U4.23 (31_A12_RX4_CS1); also elsewhere on the board
/INS/DR_ADIS16470: J7.16, U4.16 (24); also elsewhere on the board
/INS/RST_ADIS16470: J8.3, U4.32 (35_A16_PWM); also elsewhere on the board
/INS/SYNC_ADIS16470: J7.17, U4.17 (25); also elsewhere on the board
/MISO0: J7.14, U4.14 (12_MISO0); also elsewhere on the board
/MOSI0: J7.13, U4.13 (11_MOSI0); also elsewhere on the board
/Pressure Sensors/CS_RSC015_ADC: J8.14, U4.43 (16_A2_SCL0_Touch); also elsewhere on the board
/Pressure Sensors/CS_RSC015_EE: J8.15, U4.44 (17_A3_SDA0_Touch); also elsewhere on the board
/Pressure Sensors/CS_RSC060_ADC: J7.19, U4.19 (27_RX1_SCK0); also elsewhere on the board
/Pressure Sensors/CS_RSC060_EE: J7.20, U4.20 (28_MOSI0); also elsewhere on the board
/Pressure Sensors/DR_RSC015: J8.13, U4.42 (15_A1_CS0_Touch); also elsewhere on the board
/Pressure Sensors/DR_RSC060: J7.18, U4.18 (26_TX1_SCL2); also elsewhere on the board
/SCK0: J8.11, U4.40 (13_SCK0_LED); also elsewhere on the board
/Thermocouples/CS_TC1: J8.21, U4.50 (23_A9_PWM_Touch); also elsewhere on the board
/Thermocouples/CS_TC2: J8.20, U4.49 (22_A8_PWM_Touch); also elsewhere on the board
/Thermocouples/CS_TC3: J8.19, U4.48 (21_A7_PWM_CS0_MOSI1); also elsewhere on the board
/Thermocouples/CS_TC4: J8.18, U4.47 (20_A6_PWM_CS0_SCK1); also elsewhere on the board
GND: H1.1, H2.1, H3.1, H4.1, H5.1, H6.1, H7.1, H8.1, H9.1, H10.1, J2.1, J3.1, J7.1, U2.2 (GND), U4.1 (GND); also elsewhere on the board
unnamed: J1.1, U1.1
unnamed: J1.2, U1.2
unnamed: J1.3, U1.3
unnamed: J1.4, U1.4
unnamed: J2.2, J3.2, U2.1 (Vin)
unnamed: J4.1, U1.8
unnamed: J4.2, U1.7
unnamed: J4.3, U1.6
unnamed: J4.4, U1.5
unnamed: J5.1, U3.1
unnamed: J5.2, U3.2
unnamed: J5.3, U3.3
unnamed: J5.4, U3.4
unnamed: J6.1, U3.8
unnamed: J6.2, U3.7
unnamed: J6.3, U3.6
unnamed: J6.4, U3.5
unnamed: J7.2, U4.2 (0_RX1_MOSI1_Touch)
unnamed: J7.3, U4.3 (1_TX1_MISO1_Touch)
unnamed: J7.5, U4.5 (3_PWM_CAN0TX_SCL2)
unnamed: J7.6, U4.6 (4_PWM_CAN0RX_SDA2)
unnamed: J7.7, U4.7 (5_PWM_TX1_MISO1)
unnamed: J7.11, U4.11 (9_PWM_RX2_CS0)
unnamed: J7.12, U4.12 (10_PWM_TX2_CS0)
unnamed: J7.21, U4.21 (29_PWM_CAN0TX_Touch)
unnamed: J7.22, U4.22 (30_PWM_CAN0RX_Touch)
unnamed: J7.24, U4.24 (32_A13_TX4_SCK1)
unnamed: J8.1, U4.30 (33_A14_TX5_CAN1TX_SCL0)
unnamed: J8.2, U4.31 (34_A15_RX5_CAN1RX_SDA0)
unnamed: J8.5, U4.34 (37_A18_PWM_SCL1)
unnamed: J8.6, U4.35 (38_A19_PWM_SDA1)
unnamed: J8.7, U4.36 (39_A20)
unnamed: J8.8, U4.37 (A21_DAC0)
unnamed: J8.9, U4.38 (A22_DAC1)
unnamed: J8.10, U4.39 (GND)
unnamed: J8.12, U4.41 (14_A0_PWM_SCK0)
unnamed: J8.16, U4.45 (18_A4_SDA0_Touch)
unnamed: J8.17, U4.46 (19_A5_SCL0_Touch)
unnamed: J8.22, U4.51 (3.3V)
unnamed: J8.23, U4.52 (AGND)

Notes on the sheet:
Teensy
Power supply
Extra connectors

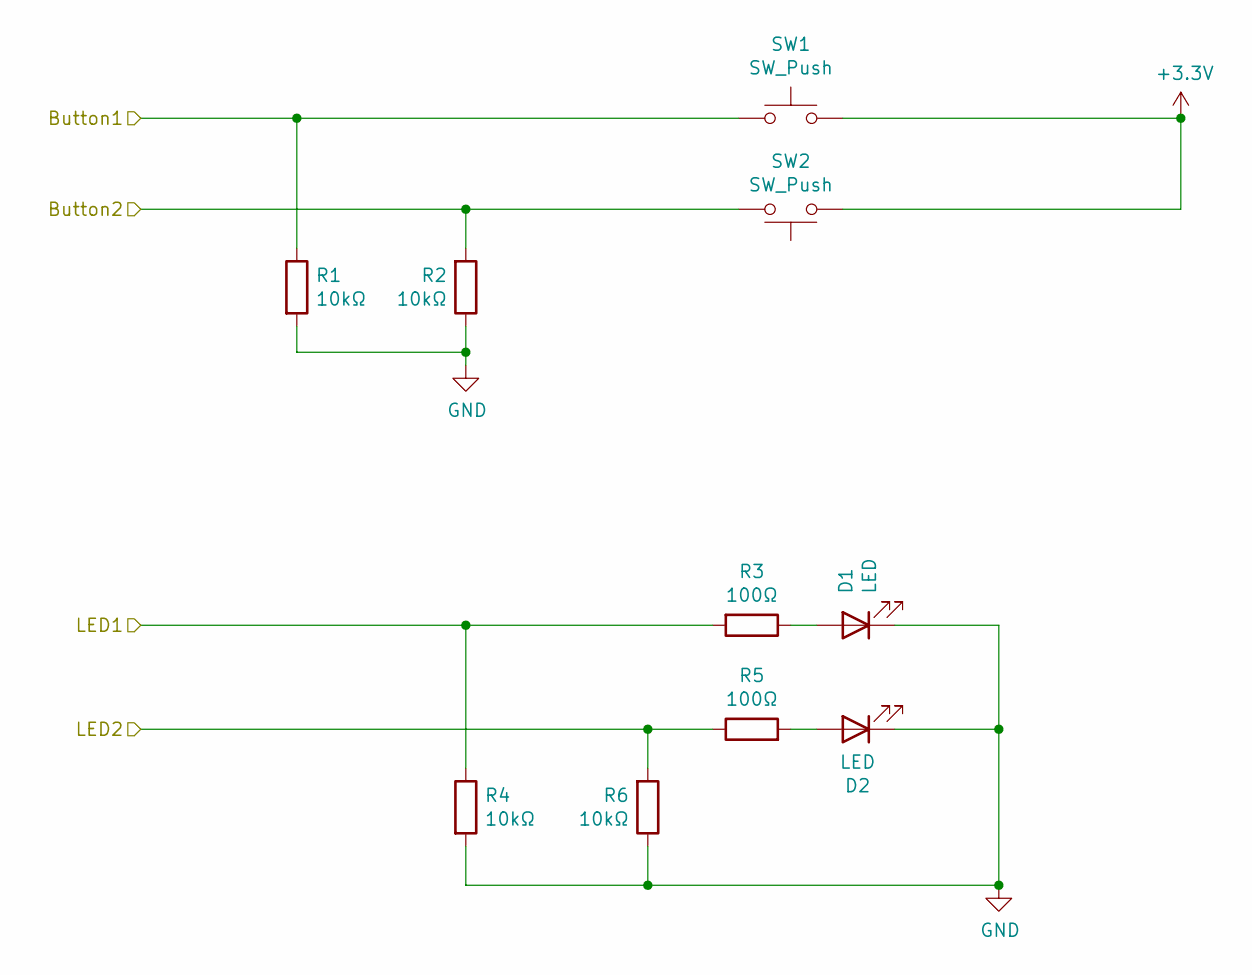
[picture p73: schematic IO.sch]

Parts:
D1, D2: LED; LED_D3.0mm
R1, R2, R4, R6: 10kΩ; R_Axial_DIN0207_L6.3mm_D2.5mm_P10.16mm_Horizontal
R3, R5: 100Ω; R_Axial_DIN0207_L6.3mm_D2.5mm_P10.16mm_Horizontal
SW1, SW2: SW_Push; SW_PUSH_6mm

Connections:
+3V3: SW1.2, SW2.1; also elsewhere on the board
/I/O/Button1: R1.1, SW1.1; also elsewhere on the board
/I/O/Button2: R2.2, SW2.2; also elsewhere on the board
/I/O/LED1: R3.2, R4.1; also elsewhere on the board
/I/O/LED2: R5.1, R6.2; also elsewhere on the board
GND: D1.1 (K), D2.1 (K), R1.2, R2.1, R4.2, R6.1; also elsewhere on the board
unnamed: D1.2 (A), R3.1
unnamed: D2.2 (A), R5.2

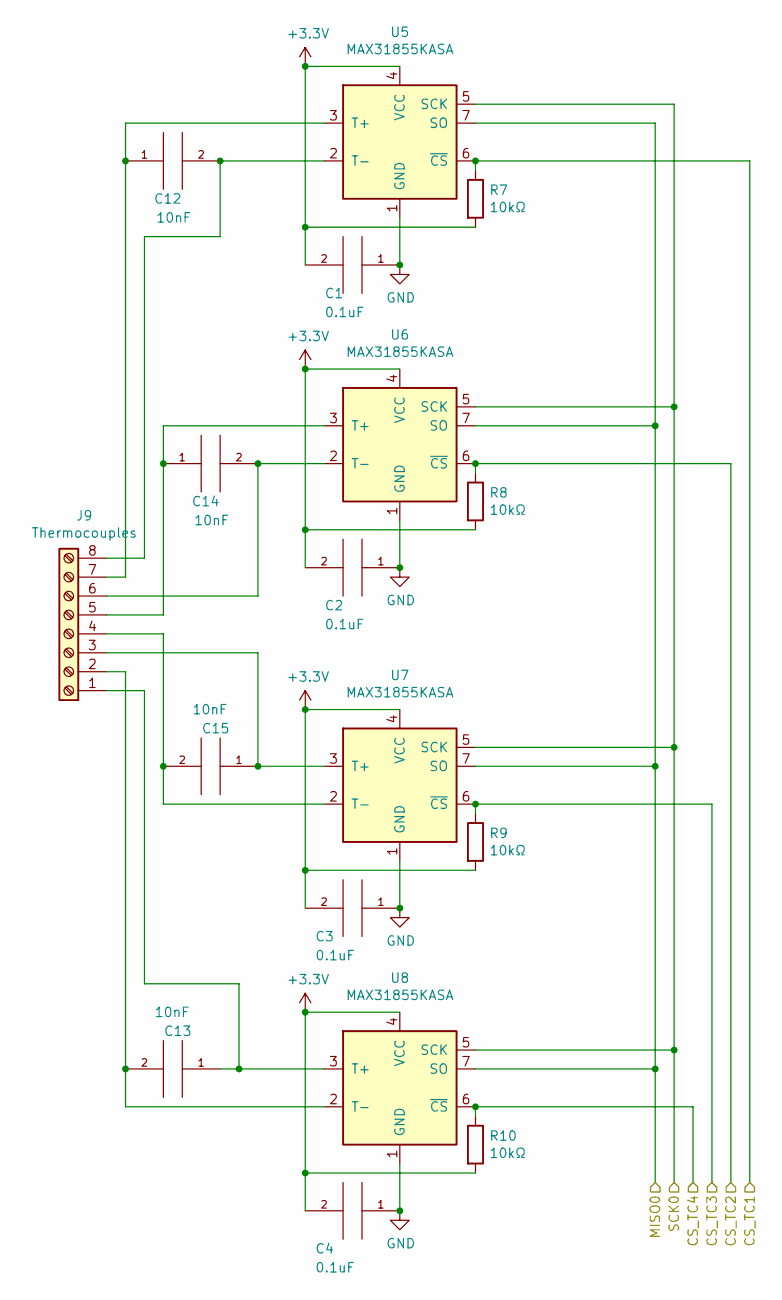
[picture p74: schematic thermocouples.sch]

Parts:
C1, C2, C3, C4: 0.1uF; C_Disc_D3.0mm_W2.0mm_P2.50mm
C12, C13, C14, C15: 10nF; C_Disc_D3.0mm_W1.6mm_P2.50mm
J9: Thermocouples; TerminalBlock_Phoenix_MPT-0,5-8-2.54_1x08_P2.54mm_Horizontal
R7, R8, R9, R10: 10kΩ; R_Axial_DIN0207_L6.3mm_D2.5mm_P10.16mm_Horizontal
U5, U6, U7, U8: MAX31855KASA; SOIC-8_3.9x4.9mm_P1.27mm

Connections:
+3V3: C1.2, C2.2, C3.2, C4.2, R7.2, R8.2, R9.2, R10.2, U5.4 (VCC), U6.4 (VCC), U7.4 (VCC), U8.4 (VCC); also elsewhere on the board
/MISO0: U5.7 (SO), U6.7 (SO), U7.7 (SO), U8.7 (SO); also elsewhere on the board
/SCK0: U5.5 (SCK), U6.5 (SCK), U7.5 (SCK), U8.5 (SCK); also elsewhere on the board
/Thermocouples/CS_TC1: R7.1, U5.6 (~CS~); also elsewhere on the board
/Thermocouples/CS_TC2: R8.1, U6.6 (~CS~); also elsewhere on the board
/Thermocouples/CS_TC3: R9.1, U7.6 (~CS~); also elsewhere on the board
/Thermocouples/CS_TC4: R10.1, U8.6 (~CS~); also elsewhere on the board
GND: C1.1, C2.1, C3.1, C4.1, U5.1 (GND), U6.1 (GND), U7.1 (GND), U8.1 (GND); also elsewhere on the board
unnamed: C12.1, J9.7, U5.3 (T+)
unnamed: C12.2, J9.8, U5.2 (T-)
unnamed: C13.1, J9.1, U8.3 (T+)
unnamed: C13.2, J9.2, U8.2 (T-)
unnamed: C14.1, J9.5, U6.3 (T+)
unnamed: C14.2, J9.6, U6.2 (T-)
unnamed: C15.1, J9.3, U7.3 (T+)
unnamed: C15.2, J9.4, U7.2 (T-)

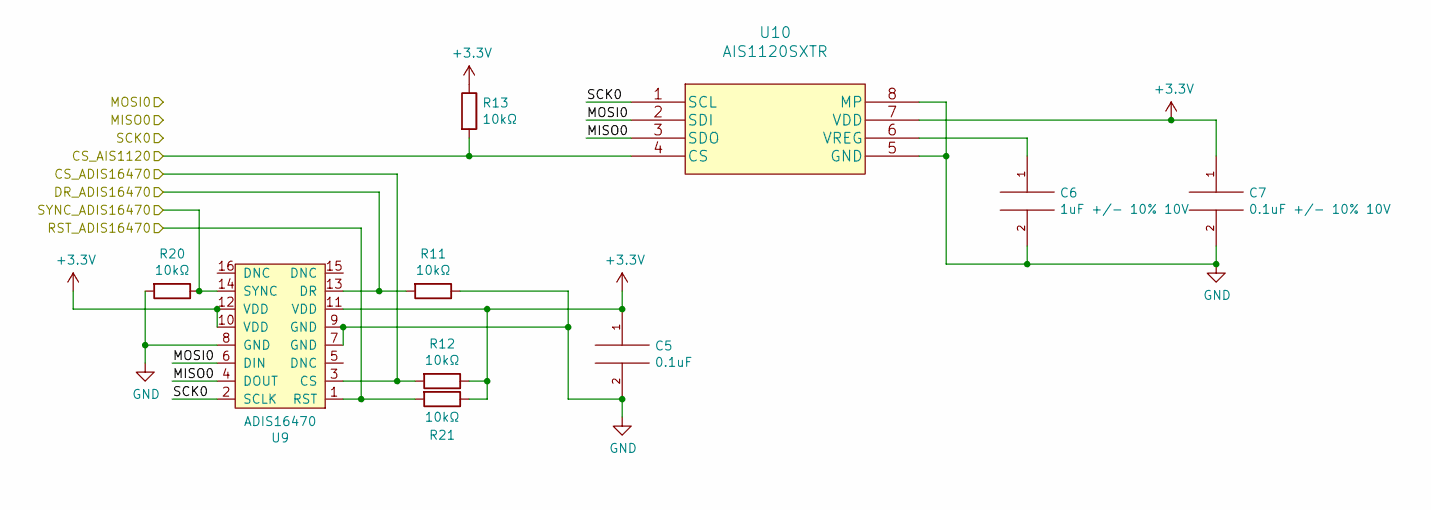
[picture p75: schematic INS.sch]

Parts:
C5: 0.1uF; C_Disc_D3.0mm_W2.0mm_P2.50mm
C6: 1uF +/- 10% 10V; C_Disc_D5.1mm_W3.2mm_P5.00mm
C7: 0.1uF +/- 10% 10V; C_Disc_D3.0mm_W2.0mm_P2.50mm
R11, R12, R13, R20, R21: 10kΩ; R_Axial_DIN0207_L6.3mm_D2.5mm_P10.16mm_Horizontal
U9: ADIS16470; PinHeader_2x08_P2.00mm_Vertical
U10: AIS1120SXTR; SOIC-8_3.9x4.9mm_P1.27mm

Connections:
+3V3: C5.1, C7.1, R12.1, R13.1, R21.1, U9.10 (VDD), U9.11 (VDD), U9.12 (VDD), U10.7 (VDD); also elsewhere on the board
/INS/CS_ADIS16470: R12.2, U9.3 (CS); also elsewhere on the board
/INS/CS_AIS1120: R13.2, U10.4 (CS); also elsewhere on the board
/INS/DR_ADIS16470: R11.2, U9.13 (DR); also elsewhere on the board
/INS/RST_ADIS16470: R21.2, U9.1 (RST); also elsewhere on the board
/INS/SYNC_ADIS16470: R20.1, U9.14 (SYNC); also elsewhere on the board
/MISO0: U9.4 (DOUT), U10.3 (SDO); also elsewhere on the board
/MOSI0: U9.6 (DIN), U10.2 (SDI); also elsewhere on the board
/SCK0: U9.2 (SCLK), U10.1 (SCL); also elsewhere on the board
GND: C5.2, C6.2, C7.2, R11.1, R20.2, U9.7 (GND), U9.8 (GND), U9.9 (GND), U10.5 (GND), U10.8 (MP); also elsewhere on the board
unnamed: C6.1, U10.6 (VREG)

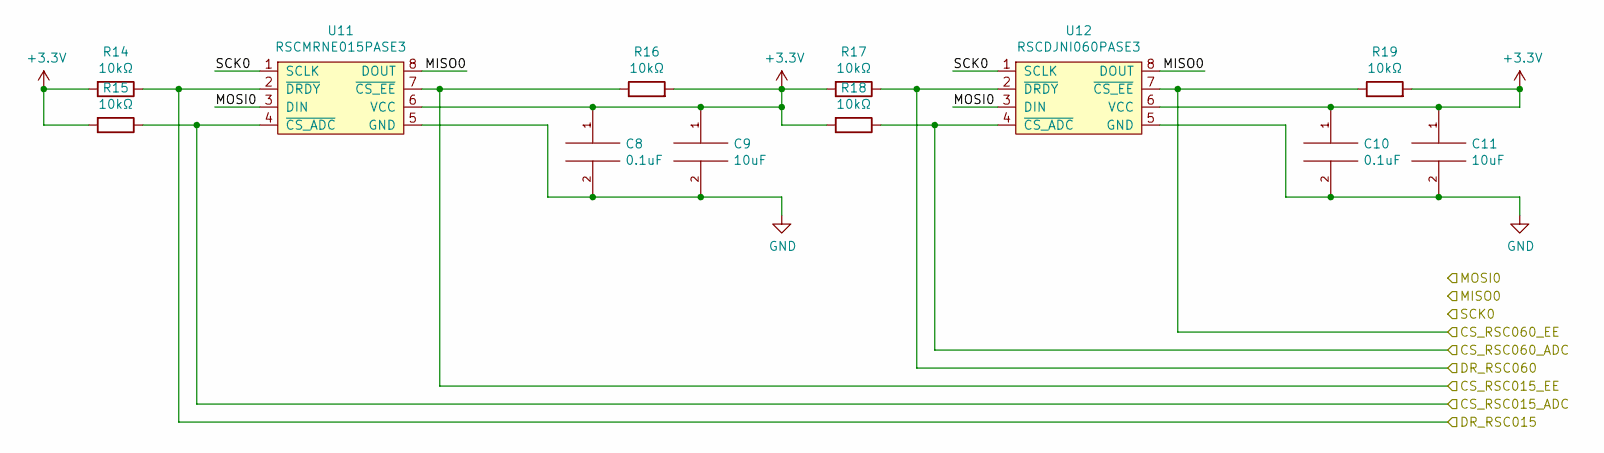
[picture p76: schematic pressureSensors.sch]

Parts:
C8, C10: 0.1uF; C_Disc_D3.0mm_W2.0mm_P2.50mm
C9, C11: 10uF; C_Disc_D6.0mm_W4.4mm_P5.00mm
R14, R15, R16, R17, R18, R19: 10kΩ; R_Axial_DIN0207_L6.3mm_D2.5mm_P10.16mm_Horizontal
U11: RSCMRNE015PASE3; SMDIP-8_W9.53mm
U12: RSCDJNI060PASE3; DIP-8_W13.08mm

Connections:
+3V3: C8.1, C9.1, C10.1, C11.1, R14.2, R15.2, R16.2, R17.2, R18.2, R19.2, U11.6 (VCC), U12.6 (VCC); also elsewhere on the board
/MISO0: U11.8 (DOUT), U12.8 (DOUT); also elsewhere on the board
/MOSI0: U11.3 (DIN), U12.3 (DIN); also elsewhere on the board
/Pressure Sensors/CS_RSC015_ADC: R15.1, U11.4 (~CS_ADC); also elsewhere on the board
/Pressure Sensors/CS_RSC015_EE: R16.1, U11.7 (~CS_EE); also elsewhere on the board
/Pressure Sensors/CS_RSC060_ADC: R18.1, U12.4 (~CS_ADC); also elsewhere on the board
/Pressure Sensors/CS_RSC060_EE: R19.1, U12.7 (~CS_EE); also elsewhere on the board
/Pressure Sensors/DR_RSC015: R14.1, U11.2 (~DRDY); also elsewhere on the board
/Pressure Sensors/DR_RSC060: R17.1, U12.2 (~DRDY); also elsewhere on the board
/SCK0: U11.1 (SCLK), U12.1 (SCLK); also elsewhere on the board
GND: C8.2, C9.2, C10.2, C11.2, U11.5 (GND), U12.5 (GND); also elsewhere on the board

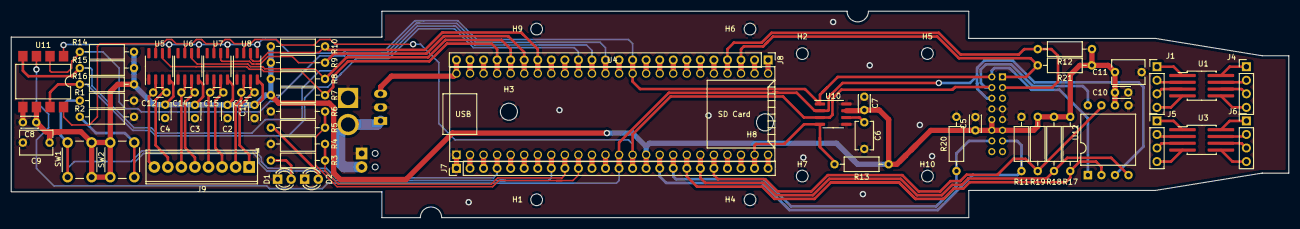
[picture p77: board PCB/PCB_v2_5/PCB_v1.kicad_pcb from above]

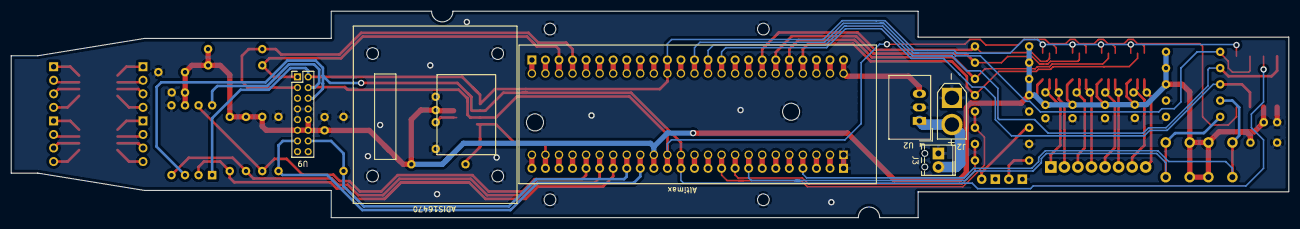
[picture p78: board PCB/PCB_v2_5/PCB_v1.kicad_pcb from below]

Board: 2 copper layers, 239.5 x 38.7 mm, 73 parts (6 on the bottom side), 76 nets.

Other parts of the board:
ADIS16470: ADIS16470
Altimax: AltimaxG4
