EPFLRocketTeam/SupersonicTestRocket/data_logger/include/Packet.hpp

#pragma once

#include <cstdlib>
#include <cstdint>
#include <cstring>
#include <cstdio>
#include <cassert>

#include <Arduino.h>
#include <ArduinoTrace.h>

#include "CustomTypes.hpp"

const uint8_t ERROR_TYPE_NUM = 5; ///< Number of errors

/// 8 byte header for all packets
struct PacketHeader
{
    packetType packetType_ = NO_PACKET; ///< Type of the packet, 1 byte
    uint8_t packetSize = 0;             ///< Size in bytes of the packet, 1 byte
    uint8_t sensorID = 0;               ///< ID of the sensor which produced the packet, 1 byte
    uint8_t errorCode = 0xff;           ///< Error code, 1 byte; @see void decodeErrorCode(bool errorArray[ERROR_TYPE_NUM], uint8_t errorCode)
    uint32_t timestamp = 0;             ///< Timestamp, in microseconds, 4 bytes
};

/// Description of errors bits in packet header
#define HEADER_ERROR_DESC \
    "\nErr code format: [Measure late] [Check beats skipped] [No DR trigger] [Checksum error] [Invalid measure]"

/// Description of packet fields
#define HEADER_LINE "--- Packet type --- | -- Packet size -- | -- Sensor ID -- | -- Error code -- | -- Timestamp -- | -- Data     \n"

/// Format for packet header's data
#define HEADER_FRMT ">: %-16.16s : %8.8u          : %8.8u        :   %1.1d  %1.1d  %1.1d  %1.1d  %1.1d  : %15.15lu | "

/// Size of the packet header's format
#define HEADER_SIZE 98

/// Filler of size HEADER_WIDTH
#define HEADER_FILLER_LINE \
    "                                                                                               | "

/// Size left after header's data
#define DATA_SIZE 32

/// Total line size (with newline and end char)
#define LINE_SIZE HEADER_SIZE + DATA_SIZE + 2

/// Separator line
#define SEPARATOR_LINE "- - - - - - - - - - - - - - - - - - - - - - - - - - - - - - - - - - - - - - - - - - - - - - - - - - - - - - - - - - - - - - - - - \n"

class Packet
{
public:
    // ----- Constructors ----- //

    /**
     * @brief Construct a new empty Packet object
     *
     * The header is default (special \c packetType_ , all values to 0, all error flags raised)
     * The data is NULL
     */
    Packet();

    /**
     * @brief Construct a new Packet object and allocate memory for data
     *
     * The header is default, except for the size (which must be positive)
     *
     * @param size Size in bytes of the expected content
     */
    Packet(uint8_t size);

    /**
     * @brief Construct a new Packet object from a given header
     *
     * Set the header to the one provided and allocate memory according the the size
     * indicated in the header
     *
     * @param header Header for the packet, must have positive size
     */
    Packet(PacketHeader &header);

    /**
     * @brief Copy constructor
     *
     * @param other
     */
    Packet(Packet &other);

    // ----- Destructor ----- //
    /**
     * @brief Destroy the Packet object
     *
     * Free Packet::content if not already to \c NULL, and set it to \c NULL
     */
    ~Packet();

    // ----- Setters ----- //
    /**
     * @brief Set the packet's content
     *
     * @param data Source pointer for data
     * @param s Number of bytes to copy
     * @return uint8_t : Number of bytes actually copied (min between \p s and Packet::header.packetSize )
     */
    uint8_t setContent(void *data, size_t s);

    /**
     * @brief Set the packet Type in the header
     *
     * @param pt
     */
    void setPacketType(packetType pt)
    {
        header.packetType_ = pt;
    }

    /**
     * @brief Set the sensor ID in the header
     *
     * @param id
     */
    void setSensorID(uint8_t id)
    {
        header.sensorID = id;
    }

    /**
     * @brief Set the error code in the header
     *
     * @param errCode
     */
    void setErrorCode(uint8_t errCode)
    {
        header.errorCode = errCode;
    }

    /**
     * @brief Set the timestamp in the header
     *
     * @param ts
     */
    void setTimestamp(uint32_t ts)
    {
        header.timestamp = ts;
    }

    /**
     * @brief Update the header with the one given
     *
     * The packet's size and type have to be the same in the current header and the one provided.
     *
     * @param h
     */
    void updateHeader(PacketHeader h);

    // ----- Getters ----- //

    /**
     * @brief Get the packet type from header
     *
     * @return packetType
     */
    packetType getPacketType()
    {
        return header.packetType_;
    }

    /**
     * @brief Get the packet size from header
     *
     * @return uint8_t
     */
    uint8_t getPacketSize()
    {
        return header.packetSize;
    }

    /**
     * @brief Get the sensor ID from header
     *
     * @return uint8_t
     */
    uint8_t getSensorID()
    {
        return header.sensorID;
    }

    /**
     * @brief Get the error code from header
     *
     * @return uint8_t
     */
    uint8_t getErrorCode()
    {
        return header.errorCode;
    }

    /**
     * @brief Get the timestamp from header, in microseconds
     *
     * @return uint8_t
     */
    uint32_t getTimestamp()
    {
        return header.timestamp;
    }

    /**
     * @brief Copy Packet::content to holder
     *
     * @param holder A buffer of size at least packetSize
     */
    void getContent(void *holder)
    {
        memcpy(holder, content, header.packetSize);
    }

    /**
     * @brief Write the content in Big Endian format into the buffer
     *
     * @param buffer A buffer of size at least packetSize
     */
    virtual void getBigEndian(void *buffer) = 0;

    // ----- Accessors ----- //

    /**
     * @brief Get a pointer to the packet's header
     *
     * @return PacketHeader*
     */
    PacketHeader *accessHeader()
    {
        return &header;
    }

    /**
     * @brief Get a copy of the data pointer
     *
     * @return void*
     */
    void *accessContent()
    {
        return content;
    }

    /**
     * @brief Fill the input buffer with a printable description of the packet's header
     *
     * @param output A buffer to fill with data, of size \c PACKET_HEADER_PRINT_SIZE
     */
    void getPrintableHeader(char *buff);

    /**
     * @brief Fill the given \c char* buffer with the \c size_t line of printable description of the packet's content
     *
     * @return int : 1 if there if another line to get, 0 if there no next line
     */
    virtual int getPrintableContent(char *, size_t) = 0;

protected:
    PacketHeader header;
    void *content = NULL;
};

/**
 * @brief Convert a boolean errors' array to an error code (binary encoding)
 *
 * @param errorArray An error code array, of size ERROR_TYPE_NUM
 * @return uint8_t : The corresponding error code
 *
 * @see Sensor::errors
 */
uint8_t getErrorCode(bool *errorArray);

/**
 * @brief Convert an error code into the corresponding boolean array
 *
 * @param errorArray An error to store the result
 * @param errorCode An error code (errors encoded in binary)
 *
 * @see Sensor::errors
 */
void decodeErrorCode(bool errorArray[ERROR_TYPE_NUM], uint8_t errorCode);
