EPFLRocketTeam/SupersonicTestRocket/data_logger/src/Sensors/HoneywellRscWrapper.cpp

/*
 * HoneywellRscWrapper.cpp
 *
 *  Created on: 2021-04-26
 *      Author: Joshua Cayetano-Emond
 */

#include "HoneywellRscWrapper.hpp"

// initialize the sensor count
uint8_t HoneywellRscWrapper::sensorQty = 0;

// ----- constructors ----- //
HoneywellRscWrapper::HoneywellRscWrapper(int DR,
                                         int CS_EE,
                                         int CS_ADC,
                                         int SPI_BUS,
                                         RSC_DATA_RATE data_r,
                                         uint32_t desired_P)
    : Sensor(sensorQty),
      rscObject(DR, CS_EE, CS_ADC, SPI_BUS),
      lastPressurePacket(Sensor::getHeader(
          RSC_PRESSURE_PACKET_TYPE,
          sizeof(HoneywellRSCBody),
          0)),
      lastTempPacket(Sensor::getHeader(
          RSC_TEMP_PACKET_TYPE,
          sizeof(HoneywellRSCBody),
          0)),
      lastPackets{&lastPressurePacket, &lastTempPacket},
      data_rate(data_r),
      desiredTempPeriod(desired_P)
{
  sensorQty += 1;
  active = false;
}

// ----- destructor ----- //
HoneywellRscWrapper::~HoneywellRscWrapper()
{
  sensorQty -= 1;
}

bool HoneywellRscWrapper::setup(uint32_t attempts, uint32_t delayDuration)
{
  // Setup the timing parameters

  // Try to see if the RSC is working
  for (uint32_t i = 0; i < attempts; i++)
  {
    rscObject.init(data_rate); // initialize the object

    pressureMin = rscObject.pressure_minimum();
    pressureMax = rscObject.pressure_range() + pressureMin;
    // try to make a dummy measurement
    rscObject.adc_request(PRESSURE);
    delay(50);
    float reading = rscObject.get_pressure();
    //Serial.printf("[HoneywellRSC] Setup pressure reading: %f\n", reading);
    if (reading != 0 && !isnan(reading)) // condition for success
    {
      active = true;
      uint16_t dr_delay = rscObject.calc_dr_delay();
      temp_frequency = floor(desiredTempPeriod / dr_delay);
      setupProperties(dr_delay, dr_delay, dr_delay, true);

      rscObject.adc_request(nextReadType());
      measurementAmountModulo += 1;
      return active;
    }
    else // give it time before the next try
    {
      delay(delayDuration);
    }
  }
  active = false;
  return active; // setup was not succesful
}

uint8_t HoneywellRscWrapper::getSensorQty()
{
  return sensorQty;
}

bool HoneywellRscWrapper::isDue(uint32_t currMicros, volatile bool &triggeredDR)
{
  if (isDueByDR(currMicros, triggeredDR)) // || isDueByTime(currMicros)) //Removed dueByTime to avoid packet type confusion
  {
    prevMeasTime = currMicros;
    // determine the type of measurement we are getting
    if (currReadType() == TEMPERATURE)
    {
      lastTempPacket.setMeasurement(rscObject.get_temperature());
      lastTempPacket.updateHeader(Sensor::getHeader(RSC_TEMP_PACKET_TYPE,
                                                    sizeof(HoneywellRSCBody),
                                                    currMicros));

      // request the next data from the adc
      rscObject.adc_request(nextReadType());

      // update the measurement count
      measurementAmountModulo += 1;
      measurementAmountModulo = measurementAmountModulo % temp_frequency;
      return &lastTempPacket;
    }
    else
    {
      lastPressurePacket.setMeasurement(rscObject.get_pressure());
      lastPressurePacket.updateHeader(Sensor::getHeader(RSC_PRESSURE_PACKET_TYPE,
                                                        sizeof(HoneywellRSCBody),
                                                        currMicros));

      // request the next data from the adc
      rscObject.adc_request(nextReadType());

      // update the measurement count
      measurementAmountModulo += 1;
      measurementAmountModulo = measurementAmountModulo % temp_frequency;
      return &lastPressurePacket;
    }
    return true;
  }
  else
  {
    return false;
  }
}

bool HoneywellRscWrapper::isMeasurementInvalid()
{
  if (lastPressurePacket.getMeasurement() > pressureMax ||
      lastPressurePacket.getMeasurement() < pressureMin ||
      lastTempPacket.getMeasurement() > TEMP_MAX ||
      lastTempPacket.getMeasurement() < TEMP_MIN)
  {
    return true;
  }
  return false;
}

READING_T HoneywellRscWrapper::currReadType()
{
  // temperature readings are requested when modulo == 0
  // therefore the next measurement (modulo == 1) is a temperature reading
  if (measurementAmountModulo == 1)
  {
    return TEMPERATURE;
  }
  else
  {
    return PRESSURE;
  }
}

READING_T HoneywellRscWrapper::nextReadType()
{
  // temperature readings are requested when modulo == 0
  if (measurementAmountModulo == 0)
  {
    return TEMPERATURE;
  }
  else
  {
    return PRESSURE;
  }
}

HoneywellRSCPacket *HoneywellRscWrapper::getPacket()
{
  if (lastPressurePacket.getTimestamp() > lastTempPacket.getTimestamp())
  {
    return &lastPressurePacket;
  }
  else
  {
    return &lastTempPacket;
  }
}

HoneywellRSCPacket **HoneywellRscWrapper::getSerialPackets(uint32_t currMicros)
{
#ifdef DEBUG
  lastPressurePacket.setMeasurement(generateFakeData(0, 2, micros(), 14 * SENSOR_ID));
  lastPressurePacket.updateHeader(getHeader(currMicros));
  lastTempPacket.setMeasurement(generateFakeData(-200, 1200, micros(), 25 * SENSOR_ID, 3800000));
  lastTempPacket.updateHeader(getHeader(currMicros));
#endif

  return lastPackets;
}

PacketHeader HoneywellRscWrapper::getHeader(uint32_t currMicros)
{
  if (currReadType() == TEMPERATURE)
  {
    return Sensor::getHeader(RSC_TEMP_PACKET_TYPE,
                             sizeof(HoneywellRSCBody),
                             currMicros);
  }
  else // currReadType() == PRESSURE
  {
    return Sensor::getHeader(RSC_PRESSURE_PACKET_TYPE,
                             sizeof(HoneywellRSCBody),
                             currMicros);
  }
}
