EPFLRocketTeam/SupersonicTestRocket/(commit log)

2021-04-06 transferred code from the previous (private) repository
    [i600_10Hz.csv, i600_simulation.csv]
2021-04-20 added buttons and event to start/stop logging
2021-04-21 transferred button functions into separate file
2021-04-21 fixed a few bugs when switching states
    [main.cpp]
2021-04-22 some cleanup for button functions
2021-04-22 setup data acquisition with separate tasks for each sensor
2021-04-22 add beat skip checking
    [dataAcquisition.cpp, logging.cpp, main.cpp]
2021-04-23 matlab decoder
    [AIS.csv, IMU.csv, RSC.csv, Temp.csv]
2021-04-24 created i/o file. setup libraries for sensors and added boot checks
    also did a bit of housecleaning for the file structure
    [AIS.csv, IMU.csv, RSC.csv, Temp.csv]
2021-04-26 added TC and RSC. started sensor and wrapper classes
2021-04-29 Added MTP, fixed a few bugs and wrote the readme
    [HoneywellRscWrapper.cpp, dataAcquisition.cpp, main.cpp, mtp.ino]
2021-04-30 button tests half written
2021-04-30 finished button testing
2021-05-02 added PCB and testing for the AIS library
    [INS.sch, IO.sch, PCB_v1.kicad_pcb, PCB_v1.sch, adis16470_outline.dxf, altimax_outline.dxf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]
2021-05-07 added the decoders for the other sensors
    and made logging start automatically
2021-05-22 rearrange file structure that was bugged because of different case in names
    [dataAcquisition.cpp, io.cpp, logging.cpp, main.cpp]
2021-05-23 fixed issues for the MAX and ADIS sensors
    [main.cpp]
2021-06-02 made DR lines interrupt-driven
2021-06-13 added data from the first flight
    [RSC_pressure1.csv, RSC_temp1.csv, RSC_temp2.csv, Temp1.csv, Temp2.csv, Temp3.csv, Temp4.csv]
2021-06-14 cleanup from old interrupts and bug in decoder
2021-06-19 added altimax interrupt and fixing some timing issues
    [dataAcquisition.cpp, main.cpp]
2021-07-12 preparing rest of code to work with GS
    mainly fixed the wrappers and the packets that they called
    [dataAcquisition.cpp, main.cpp]
2021-07-16 serial packet values now have fixed size arrays
    TODO: change this to work with pointers properly
    [dataAcquisition.cpp, main.cpp]
2021-07-17 added invalid measurement error+mach/airspeed readings
    [main.cpp]
2021-07-18 created flowCalculations file
2021-07-27 fixed altitude calculation and inactive sensors no longer send serial data
    [main.cpp]
2021-07-31 code for error checking and red light for bug in ADIS
    [Dashboard.py, checkErrors.py, dataAcquisition.cpp, fileManager.py, main.cpp]
2021-08-01 improved serial output and added error latching
    still some bugs to fix. namely, text decoration doesn't work properly
    [dataAcquisition.cpp, main.cpp]
2021-09-04 plotFlight module
    [RSC_pressure1.csv, RSC_temp1.csv, RSC_temp2.csv, Temp1.csv, Temp2.csv, Temp3.csv, Temp4.csv]
2021-10-17 added 3d plotter and logs from Cernier
    [Cernier Launch [08.11.21].xlsx, Cernier_Launch_[08.11.21].xlsx]
2021-10-17 added Cernier data for real
    [MAX_0.csv, MAX_1.csv, MAX_2.csv, RSC_temp_1.csv, out_0.csv]
2021-11-03 create new branch and cleanup folder structure
    [Cernier_Launch_[08.11.21].xlsx, hermes2_mission_profile_study.csv]
2021-11-04 thrust curve analysis
2021-11-12 Rework of setup: Use virtual class Sensor to streamline setup
    [main.cpp]
2021-11-12 Added missing ; Started adapting `acquireData`
    [dataAcquisition.cpp, dataAcquisition.hpp, main.cpp]
2021-11-12 Compilable new dataAcquisition (Use virtual Packet and Sensor) Removed calls to "serialOutput" (may need rework since virtual inputs)
    [dataAcquisition.cpp, globalVariables.hpp, main.cpp]
2022-01-04 started routing
    [INS.sch, IO.sch, PCB_v1.kicad_pcb, PCB_v1.sch, adis16470_outline.dxf, altimax_outline.dxf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]
2022-01-04 Started PCB v1.5
    - Added diode to schematic to stop Altimax from beeping when USB powered
    - Reduced PCB size to fit in 100x40mm
    - Changed some pins on the Teensy and started routing
    [INS.sch, IO.sch, PCB_v1.kicad_pcb, PCB_v1.sch, adis16470_outline.dxf, altimax_outline.dxf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]
2022-02-08 Documented Sensor class Updated `errors` storage
2022-02-08 Style corrections for Doxygen
    [CustomTypes.hpp, Packet.cpp, Packet.hpp]
2022-02-09 Added interface for Serial printing of packets
2022-02-09 Added Printable body for ADIS Removed DR_PIN since unused
2022-02-09 Added getPrintableContent for the other sensors
2022-02-11 Added 'lastPackets' to store pointers to the two types of packets (pressure and temperature) Partial documentation; to be completed after review of the actual sensor driver
2022-02-12 deleted documentation
    Documentation was already added by @spacewolfXfr in recent commits, so this older version of documentation has been deleted in case there are any conflicts and to avoid any confusion. There might be some remnants of it left somewhere in the folder structure, so if this is found in the future, it should be deleted.
2022-02-22 Moved error encoding/decoding to Packet.hpp
    [Packet.cpp, Packet.hpp]
2022-02-22 Size correction for Serial printing
    [dataAcquisition.cpp, dataAcquisition.hpp]
2022-02-22 Moved Sensors to src
2022-02-25 fixed issues with SD card logging
    [CODE_CPOV_PCB_V4_FONCTIONNEL.ino]
2022-02-26 refactored code and did minor memory optimizations
    commented and reformatted the code to be a bit cleaner.
    still missing the recovery section to reformat
    [CODE_CPOV_PCB_V4_FONCTIONNEL.ino]
2022-02-27 bug fixes
    moved some variables to be global
    put beeps back in milliseconds
    [CODE_CPOV_PCB_V4_FONCTIONNEL.ino]
2022-03-03 Switched to DEBUG mode New serial printing
2022-03-14 added motors
2022-03-19 Added ground station
2022-03-19 Copy of ground station commited
    [codestyle.cfg]
2022-03-19 Renamed to original name
    [codestyle.cfg]
2022-03-19 started first version of load cell wrapper
    still doesn't work. a few things to figure out regarding packet reading
    [AD8556Wrapper.cpp, AD8556Wrapper.hpp, CustomTypes.hpp]
2022-03-20 Bug correction, import from GS only needed file
    [Packet.hpp, XB8XWrapper.hpp]
2022-03-22 Updated link from GS to data_logger sensors
2022-03-25 Debug + update PCB
    [PCB_v1.kicad_pcb]
2022-03-26 Changed back printing
2022-03-26 Corrected setup for XB8X
    [XB8XWrapper.cpp]
2022-03-26 Updated AD8556 Wrapper Update PCB
2022-04-30 renamed directory
    [codestyle.cfg]
2022-05-04 Correctde number of sensors
    [globalVariables.hpp]
2022-05-10 Now return error on unsuccessful setup
    [logging.cpp, logging.hpp]
2022-05-10 Corrected Packet ID for load cell
    [Packet.py]
2022-05-10 Typo correction + Started improving plotting (Streamlining)
    [Packet.py, plotFlight.py]
2022-05-12 Fixed baud rate for radio
    [main.cpp]
2022-05-13 HERMES 2 ready to fligh with Brique Sensors ready: - GPS - ADIS - TC1 - RSC
2022-06-13 Added dummy data and datasheets
    [AD8556_0.csv, ADIS16470_0.csv, RSC_pressure_0.csv, RSC_temp_0.csv]
